phoenix9668/Collector/Doc/Collector Case Design/Collector antenna 1.jpg

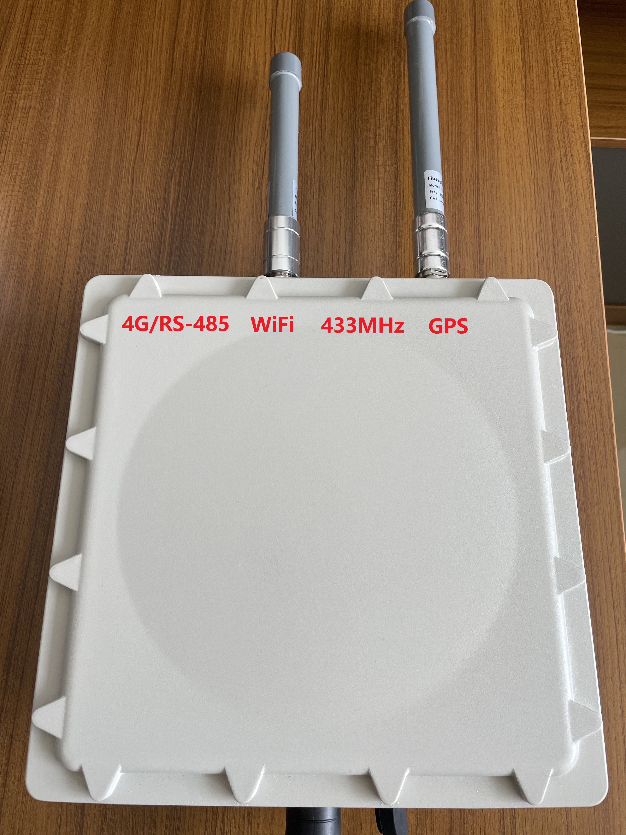
Doc/Collector Case Design/Collector antenna 1.jpg
