phoenix9668/Collector/Doc/Collector Case Design/Collector antenna 2.jpg

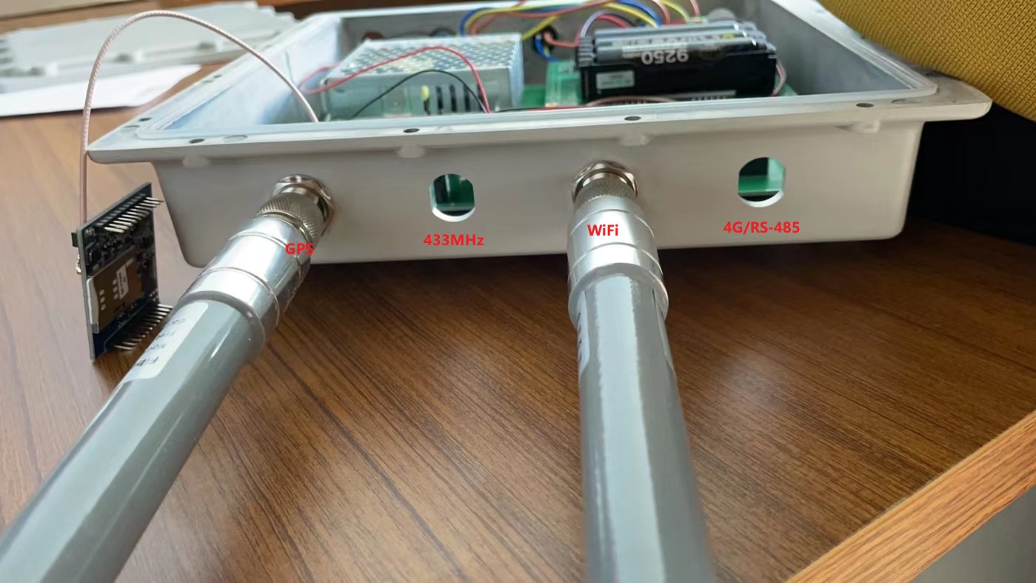
Doc/Collector Case Design/Collector antenna 2.jpg
