phoenix9668/Collector/README.md

# Collector
Collector code using freeRTOS on stm32l051c8t6.

Function Include:
1. CC1101 drive;
2. USART using DMA for efficient RX and TX transmission;
3. I2C-Compatible Serial Interface for SGM58031.
