phoenix9668/Collector/Doc/Collector Case Design/268×268×65mm case/基站印刷体.jpg

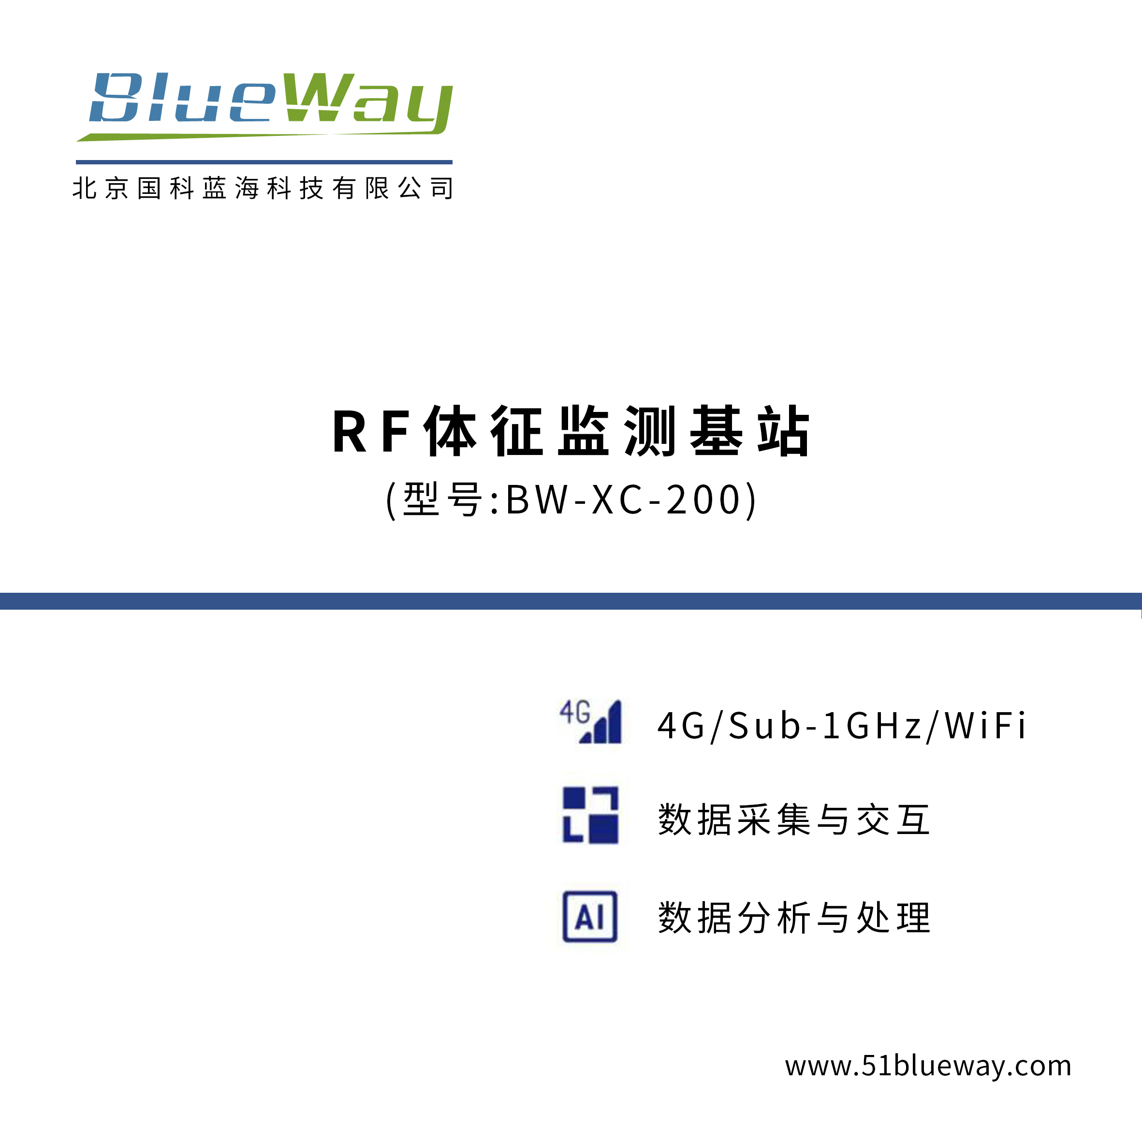
Doc/Collector Case Design/268×268×65mm case/基站印刷体.jpg
