phoenix9668/Collector/Doc/Collector Case Design/Collector Case-2.png

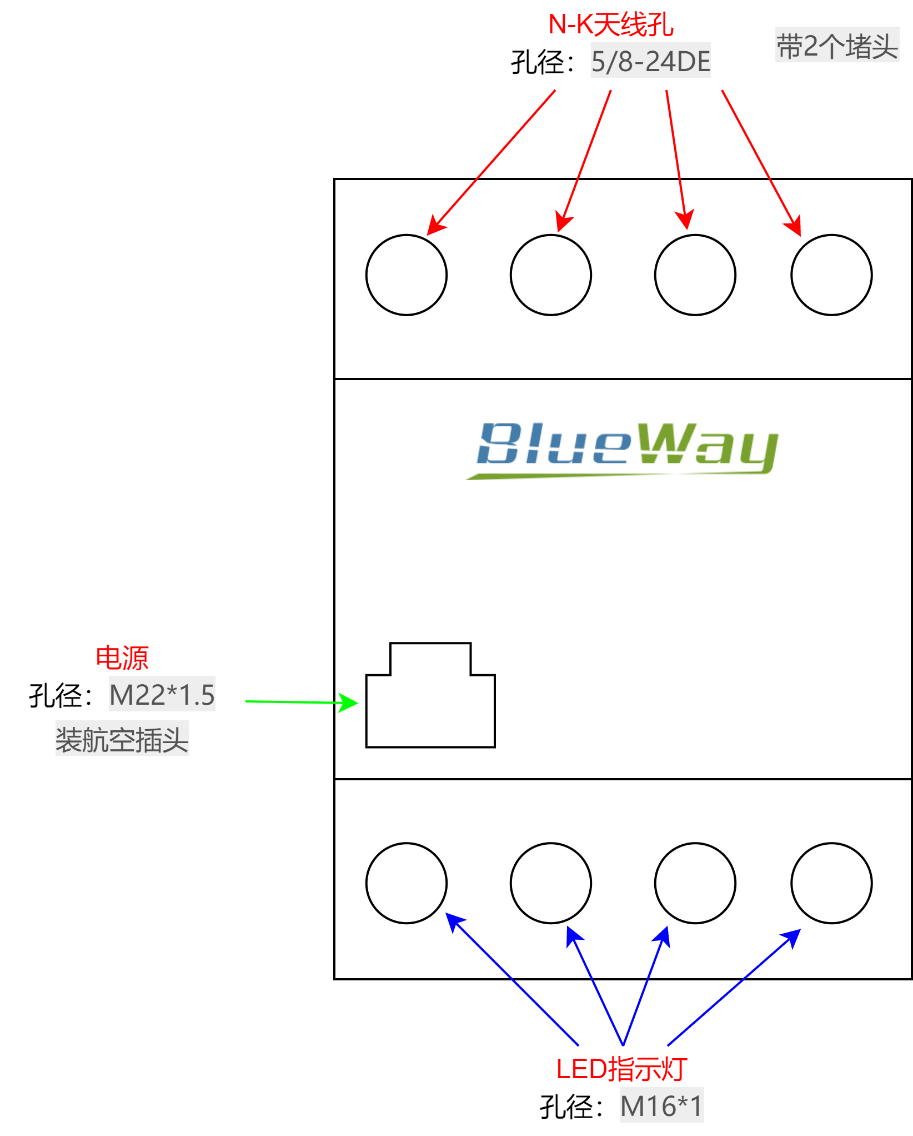
Doc/Collector Case Design/Collector Case-2.png
