phoenix9668/Collector/Doc/Collector Case Design/Collector Case.png

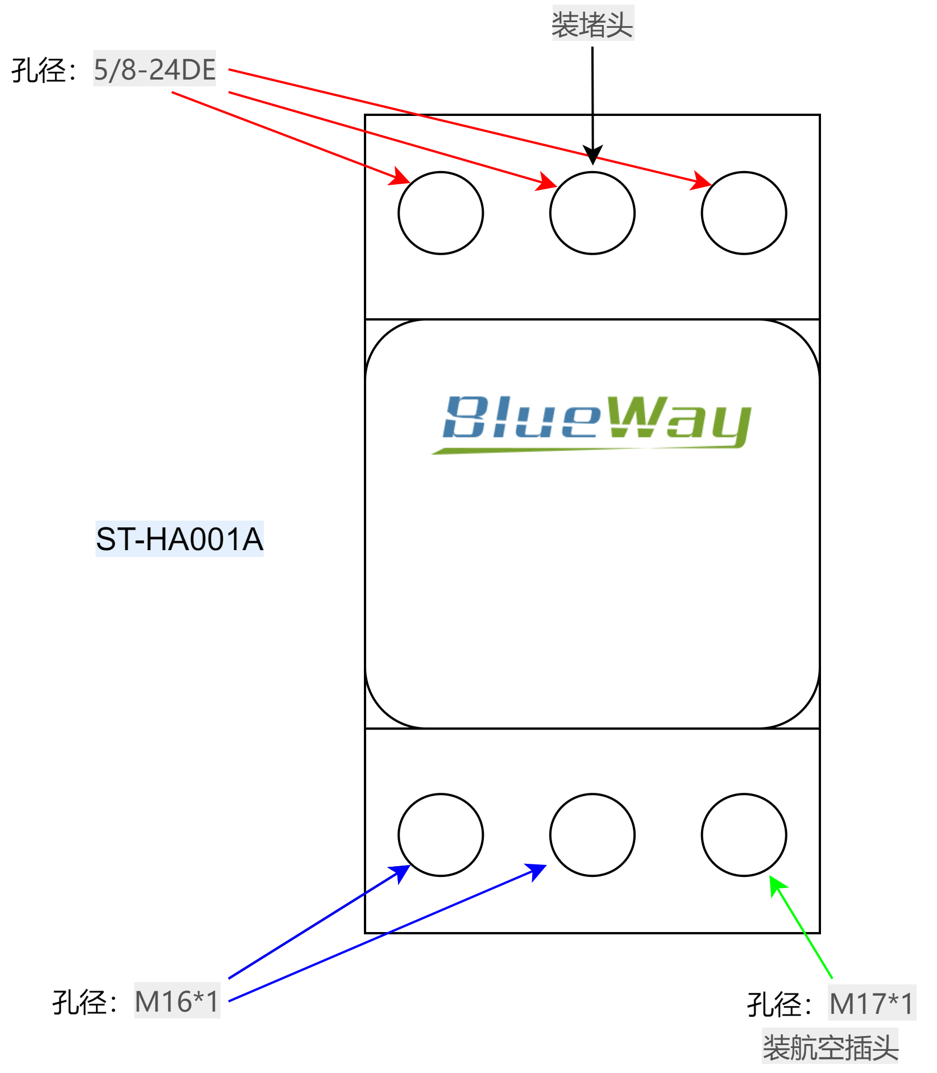
Doc/Collector Case Design/Collector Case.png
