phoenix9668/Collector/Doc/Hardware Protocol-Collar Hardware Send Protocol.png

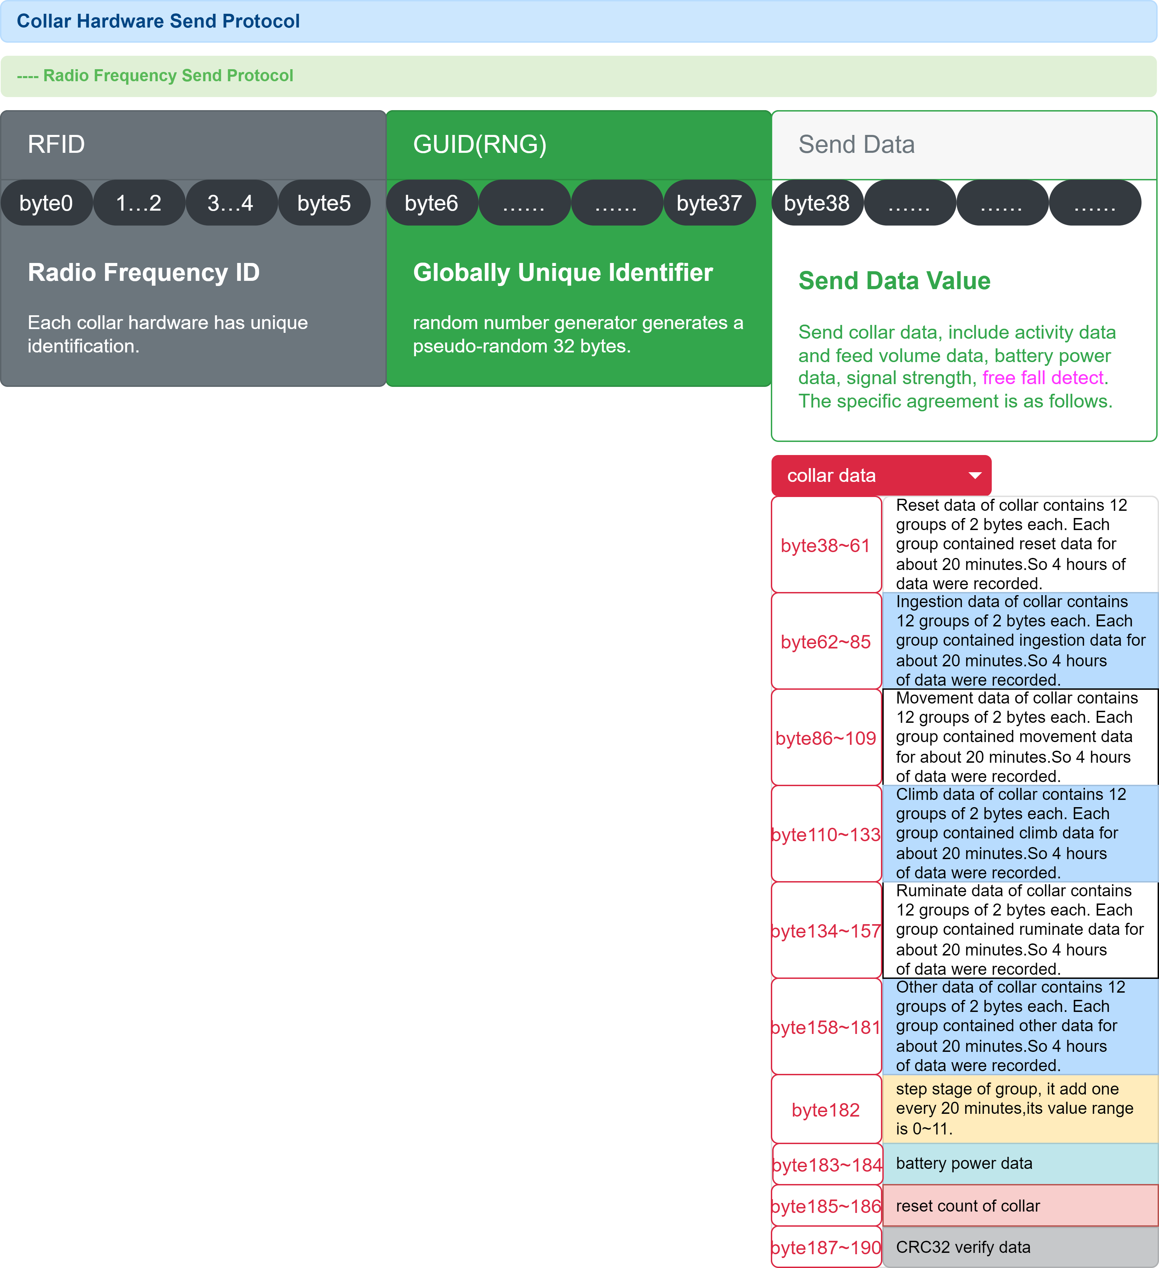
Doc/Hardware Protocol-Collar Hardware Send Protocol.png
