phoenix9668/Collector/Doc/Hardware Protocol-Collector Hardware Log Message Protocol.png

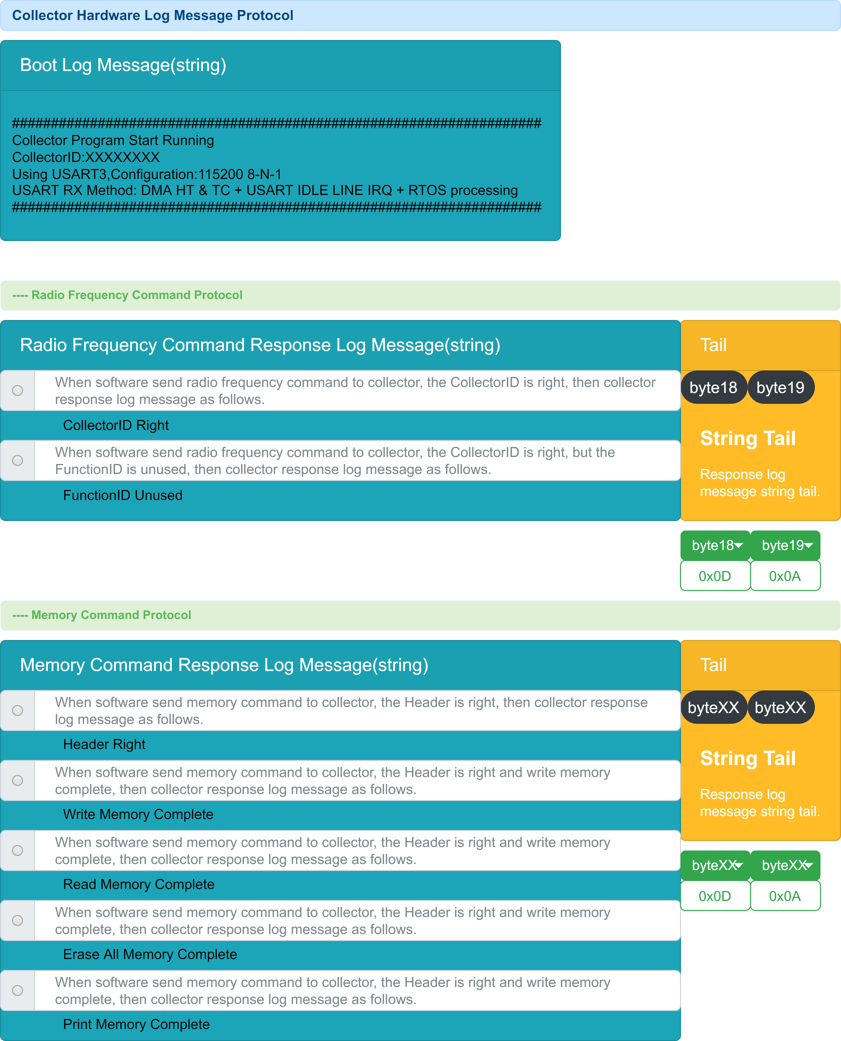
Doc/Hardware Protocol-Collector Hardware Log Message Protocol.png
