phoenix9668/Collector/Doc/Purchase Contract/Collector电路板及配件(2024.7.29)(20套).xls

Collector(20套)
壳体及其配件
Description | Quantity | Purchasing Options | Cost | Total Cost | 重要信息 | Necessary | Address | Purchasing Link
4G LTE玻璃钢全向天线 | 20 | 4G/LTE/5.5dBi/25cm/N公头 | 49 | 980 |  | 必备 | 寄往呼市办公室 | https://detail.tmall.com/item.htm?_u=e2mr66e994e&id=614809393316&skuId=4865627207627
IPEX转NK转接线 | 40 | 0.2m | 15 | 600 |  | 必备 | 寄往呼市办公室 | https://item.taobao.com/item.htm?id=620485895209
433MHz户外全向玻璃钢天线 | 20 | 433M/5dBi/48cm/N公头 | 98 | 1960 |  | 必备 | 寄往呼市办公室 | https://detail.tmall.com/item.htm?id=614809393316&_u=e2mr66e994e&skuId=4350249496926
220V转24V电源 75W 明纬 | 20 | LRS-75-24 |24V 3.2A | 55 | 1100 |  | 必备 | 寄往呼市办公室 | https://detail.tmall.com/item.htm?id=547707125576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
19mm金属指示灯 | 20 | Ø19mm | 平头 绿色 引线 3V（给客服备注） | 10.96 | 219.2 |  | 必备 | 寄往呼市办公室 | https://item.taobao.com/item.htm?spm=a1z10.5-c.w4002-20025268920.10.3d235fb6DVetfq&id=668912407685
16mm防水超短带灯 | 20 | 【复位】12-24V蓝 焊线（给客服备注） | 15 | 300 | 按照订单号: 2024060322001166131408393183提供 | 必备 | 寄往呼市办公室 | https://detail.tmall.com/item.htm?_u=22mr66e6bc4&id=677664819192&skuId=4865394269373
19mm自锁开关 | 20 | 19mm | 红色 220V 自锁开关 | 31.5 | 630 |  | 必备 | 寄往呼市办公室 | https://detail.tmall.com/item.htm?id=650041469068&skuId=5238024226194
防水航空插头 | 20 | LP20型3芯法兰正装 | 38.6 | 772 |  | 必备 | 寄往呼市办公室 | https://item.taobao.com/item.htm?spm=a1z10.5-c-s.w4002-17432376850.14.6a7935a3CgmxDe&id=565626258496
带保护板18650电池盒 | 20 |  | 36 | 720 |  | 必备 | 寄往呼市办公室 | https://item.taobao.com/item.htm?spm=a1z09.2.0.0.83f82e8dDwVs01&id=13633189376&_u=n2mr66e2dfd
德力普18650锂电池 | 20 | 平头9250mwh/2500mah*2节+【送同款1节】 | 34 | 680 |  | 必备 | 寄往呼市办公室 | https://detail.tmall.com/item.htm?id=601488730401&_u=n2mr66eae09&skuId=4204629100098
三芯电源线10A单头裸尾1平方 | 20 | 10A【1平方】3c认证 三插裸尾线 3M | 19.8 | 396 |  | 必备 | 寄往呼市办公室 | https://detail.tmall.com/item.htm?id=750570376980&_u=d2mr66ebe12&skuId=5178666565367
插头插拔式接线端子连接器2EDGK2.54 5P | 25 | 2EDGK-2.54-5P 插头（2个） | 4 | 100 |  | 必备 | 寄往呼市办公室 | https://detail.tmall.com/item.htm?id=654570375802&_u=d2mr66e8a34&skuId=4716054892312
插头插拔式接线端子连接器2EDGK5.08 2P | 20 | 2P-5.08-插头 铜方块 （5个） | 2.4 | 48 |  | 必备 | 寄往呼市办公室 | https://detail.tmall.com/item.htm?id=660116496745&skuId=4936499854311
模块
移远4G模块EC600N开发板 | 20 | 【搭载EC600UCNLB蓝牙版本】开发板QTME0028DB 80%客户选择 | 95 | 1900 |  | 必备 | 寄往呼市办公室 | https://detail.tmall.com/item.htm?id=633487849294&_u=n2mr66ed74e&skuId=4736799953269
 |  |  |  | 10405.2
