phoenix9668/Collector/Doc/Purchase Contract/Collector(体征监测基站)配件自锁开关.xls

Collector(100套)
壳体及内外部配件
Description | Quantity | Purchasing Options | Cost | Necessary | Address | Purchasing Link | Total Cost | 重要信息
19mm自锁开关 | 10 | 19mm | 红色 220V 自锁开关 | 31.5 | 必备 | 寄往呼市办公室 | https://detail.tmall.com/item.htm?id=650041469068&skuId=5238024226194 | 315
 |  |  |  |  |  |  | 315
