phoenix9668/Collector/Doc/Purchase Contract/Collector电路板及配件(2024.4.2)(10套).xls

Collector(10套)
壳体及其配件
Description | Quantity | Purchasing Options | Cost | Necessary | Address | Purchasing Link | Total Cost | 重要信息
4G LTE玻璃钢全向天线 | 10 | 4G/LTE/5.5dBi/25cm/N公头 | 49 | 必备 | 寄往呼市办公室 | https://detail.tmall.com/item.htm?_u=e2mr66e994e&id=614809393316&skuId=4865627207627 | 490
IPEX转NK转接线 | 20 | 0.2m | 15 | 必备 | 寄往呼市办公室 | https://item.taobao.com/item.htm?id=620485895209 | 300
433MHz户外全向玻璃钢天线 | 10 | 433M/5dBi/48cm/N公头 | 98 | 必备 | 寄往呼市办公室 | https://detail.tmall.com/item.htm?id=614809393316&_u=e2mr66e994e&skuId=4350249496926 | 980
220V转24V电源 75W 明纬 | 10 | LRS-75-24 |24V 3.2A | 55 | 必备 | 寄往呼市办公室 | https://detail.tmall.com/item.htm?id=547707125576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 | 550
19mm金属指示灯 | 10 | Ø19mm | 平头 绿色 引线 3V（给客服备注） | 10.96 | 必备 | 寄往呼市办公室 | https://item.taobao.com/item.htm?spm=a1z10.5-c.w4002-20025268920.10.3d235fb6DVetfq&id=668912407685 | 109.6
16mm防水超短带灯 | 10 | 【复位】12-24V蓝 焊线（给客服备注） | 15 | 必备 | 寄往呼市办公室 | https://detail.tmall.com/item.htm?_u=22mr66e6bc4&id=677664819192&skuId=4865394269373 | 150 | 按照订单号: 3681758306794062286提供
19mm自锁开关 | 10 | 19mm | 红色 220V 自锁开关 | 31.5 | 必备 | 寄往呼市办公室 | https://detail.tmall.com/item.htm?id=650041469068&skuId=5238024226194 | 315
防水航空插头 | 10 | LP20型3芯法兰正装 | 38.6 | 必备 | 寄往呼市办公室 | https://item.taobao.com/item.htm?spm=a1z10.5-c-s.w4002-17432376850.14.6a7935a3CgmxDe&id=565626258496 | 386
带保护板18650电池盒 | 10 |  | 36 | 必备 | 寄往呼市办公室 | https://item.taobao.com/item.htm?spm=a1z09.2.0.0.83f82e8dDwVs01&id=13633189376&_u=n2mr66e2dfd | 360
德力普18650锂电池 | 12 | 平头9250mwh/2500mah*2节+【送同款1节】 | 34 | 必备 | 寄往呼市办公室 | https://detail.tmall.com/item.htm?id=601488730401&_u=n2mr66eae09&skuId=4204629100098 | 408
模块
移远4G模块EC600N开发板 | 10 | 【搭载EC600UCNLB蓝牙版本】开发板QTME0028DB 80%客户选择 | 95 | 必备 | 寄往呼市办公室 | https://detail.tmall.com/item.htm?id=633487849294&_u=n2mr66ed74e&skuId=4736799953269 | 950
 |  |  |  |  |  |  | 4998.6
