phoenix9668/Collector/Doc/Purchase Contract/Collector配件(2023.11.20).xls

Collector
壳体及其配件
Description | Quantity | Purchasing Options | Cost | Necessary | Address | Purchasing Link | Total Cost | 重要信息
4G LTE玻璃钢全向天线 | 3 | 4G/LTE/5.5dBi/25cm/N公头 | 49 | 必备 | 寄往呼市办公室 | https://detail.tmall.com/item.htm?_u=e2mr66e994e&id=614809393316&skuId=4865627207627 | 147
IPEX转NK转接线 | 20 | 0.2m | 15 | 必备 | 寄往呼市办公室 | https://item.taobao.com/item.htm?id=620485895209 | 300
433MHz户外全向玻璃钢天线 | 3 | 433M/5dBi/48cm/N公头 | 98 | 必备 | 寄往呼市办公室 | https://detail.tmall.com/item.htm?id=614809393316&_u=e2mr66e994e&skuId=4350249496926 | 294
 |  |  |  |  |  |  | 741
