phoenix9668/Collector/Doc/Purchase Contract/Collector天线(2022.2.14).xls

Collector
LibRef | Quantity | Comment | Description | Footprint | Cost | Total Cost | Address | Manufacturer
4G户外全向玻璃钢天线 | 10 | 4G/LTE/6dBi/30cm/N公头 | 433/868/915MHz户外全向2.4G/5.8G/WiFi防水4G全频段玻璃钢天线 |  | 88 | 880 | 寄往呼市办公室 | https://detail.tmall.com/item.htm?id=614809393316&_u=e2mr66e994e&skuId=4350249496926
GPS/BD北斗双模卫星定位玻璃钢天线 | 10 | GPS+北斗玻璃钢天线 N公头 | GPS/BD北斗双模卫星定位天线gps玻璃钢/内置/吸盘/车载导航天线 |  | 58 | 580 | 寄往呼市办公室 | https://detail.tmall.com/item.htm?id=615922225062&scene=taobao_shop&skuId=4486120856083
433MHz户外全向玻璃钢天线 | 10 | 433M/5dBi/48cm/N公头 | 433/868/915MHz户外全向2.4G/5.8G/WiFi防水4G全频段玻璃钢天线 |  | 118 | 1180 | 寄往呼市办公室 | https://detail.tmall.com/item.htm?id=614809393316&_u=e2mr66e994e&skuId=4350249496926
 | 100 | 433M/4dBi/20cm/N公头 | 433/868/915MHz户外全向2.4G/5.8G/WiFi防水4G全频段玻璃钢天线 |  | 78 | 7800 | 寄往呼市办公室
N-K转接线 | 10 | N-K转SMA-J转接线/线长1米 | 玻璃钢天线固定夹码抱窋/N-K转接线N-K磁铁吸盘底座安装配件3D-FB |  | 28 | 280 | 寄往呼市办公室 | https://detail.tmall.com/item.htm?id=620297916107&spm=a1z09.2.0.0.38882e8dRRjwCa&_u=e2mr66e8020
 |  |  |  |  |  | 10720
