phoenix9668/Collector/Doc/Purchase Contract/4G模组和网络分析仪(2025.4.6).xls

网络分析仪(1套)
Description | Quantity | U8编码 | Purchasing Options | Cost | Total Cost | Necessary | Address | Purchasing Link
EC200X QuecPython开发板 | 1 |  | 【搭载EC200UEUAA模块】开发板QTMKFB0006DP | 315 | 315 | 必备 | 寄往呼市办公室 | https://detail.tmall.com/item.htm?id=826342921519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
LibreVNA2025网络分析仪 | 1 |  | 2025增强版LibreVNA | 3346.5 | 3346.5 | 必备 | 寄往呼市办公室 | https://item.taobao.com/item.htm?id=756767130374&skuId=5713249256603
高速ADC数据采集开发板 | 1 |  | 颜色分类：高速数据采集（套餐3） 标配+10位双通道高速ADC 套餐类型：XC7A100T+Xilinx下载器 | 1335.6 | 1335.6 | 必备 | 寄往呼市办公室 | https://detail.tmall.com/item.htm?id=820919611334&skuId=5536354565553
 |  |  |  |  | 4997.1
