phoenix9668/Collector/Doc/Purchase Contract/Collector(体征监测基站)生产BOM((100套).xls

Collector(100套)
壳体及内外部配件
Description | Quantity | Purchasing Options | Cost | Necessary | Address | Purchasing Link | Total Cost | 重要信息
铸铝防水壳体 | 100 | （裸壳）+卡具 | 310 | 必备 | 寄往呼市办公室 | https://item.taobao.com/item.htm?spm=a1z09.2.0.0.4acc2e8dhRLuoy&id=625369751753&_u=h2mr66e95b3 | 31000 | 我有此工厂淘宝客服的微信（17802788185），按100套走价格会有优惠，需要砍价
4G LTE玻璃钢全向天线 | 100 | 4G LTE 天线 | 50 | 必备 | 寄往呼市办公室 |  | 5000
IPEX转NK转接线 | 100 | 2根IPEX转NK | 30 | 必备 | 寄往呼市办公室 |  | 3000
天线接口激光镭射丝印 | 100 | 联系客服 | 20 | 必备 | 寄往呼市办公室 |  | 2000
logo印刷费 | 100 | 联系客服 | 15 | 必备 | 寄往呼市办公室 |  | 1500
GPS/BD北斗双模卫星定位玻璃钢天线 | 0 | GPS+北斗玻璃钢天线 N公头 | 58 | 选配 | 寄往呼市办公室 | https://detail.tmall.com/item.htm?id=615922225062&scene=taobao_shop&skuId=4486120856083 | 0 | 数量为0的本次不需要采购，下同
433MHz户外全向玻璃钢天线 | 100 | 433M/4dBi/20cm/N公头 | 78 | 必备 | 寄往呼市办公室 | https://detail.tmall.com/item.htm?id=614809393316&_u=e2mr66e994e&skuId=4350249496926 | 7800
220V转24V电源 75W 明纬 | 100 | LRS-75-24 |24V 3.2A | 63 | 必备 | 寄往呼市办公室 | https://detail.tmall.com/item.htm?id=547707125576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 | 6300
19mm金属指示灯 | 100 | Ø19mm | 平头 绿色 引线 3V（给客服备注） | 10.96 | 必备 | 寄往呼市办公室 | https://item.taobao.com/item.htm?spm=a1z10.5-c.w4002-20025268920.10.3d235fb6DVetfq&id=668912407685 | 1096
16mm防水超短带灯 | 100 | 【复位】12-24V蓝 焊线（给客服备注） | 15 | 必备 | 寄往呼市办公室 | https://detail.tmall.com/item.htm?_u=22mr66e6bc4&id=677664819192&skuId=4865394269373 | 1500 | 按照订单号: 2024060322001166131408393183提供
19mm自锁开关 | 100 | 19mm | 红色 220V 自锁开关 | 31.5 | 必备 | 寄往呼市办公室 | https://detail.tmall.com/item.htm?id=650041469068&skuId=5238024226194 | 3150
防水航空插头 | 100 | LP20型3芯法兰正装 | 38.6 | 必备 | 寄往呼市办公室 | https://item.taobao.com/item.htm?spm=a1z10.5-c-s.w4002-17432376850.14.6a7935a3CgmxDe&id=565626258496 | 3860
带保护板18650电池盒 | 100 |  | 36 | 必备 | 寄往呼市办公室 | https://item.taobao.com/item.htm?spm=a1z09.2.0.0.83f82e8dDwVs01&id=13633189376&_u=n2mr66e2dfd | 3600
5.5-2.1DC公插头 | 100 |  | 1.5 | 必备 | 寄往呼市办公室 | https://item.taobao.com/item.htm?spm=a1z09.2.0.0.83f82e8dDwVs01&id=17908412942&_u=n2mr66ecb35 | 150
德力普18650锂电池 | 100 | 平头9250mwh/2500mah*2节+【送同款1节】 | 34 | 必备 | 寄往呼市办公室 | https://detail.tmall.com/item.htm?id=601488730401&_u=n2mr66eae09&skuId=4204629100098 | 3400
第三方电路板模块 |  |  |  |  |  |  | 0
移远4G模块EC600N开发板 | 100 | 【搭载EC600MCNLE模块】开发板QTME0068DM | 199 | 必备 | 寄往呼市办公室 | https://detail.tmall.com/item.htm?id=633487849294&_u=n2mr66ed74e&skuId=4736799953269 | 19900
有人物联网4G模块 | 0 | 新版V2（V1版迭代产品） | 138 | 选配 | 寄往呼市办公室 | https://detail.tmall.com/item.htm?id=540412354139&scene=taobao_shop&skuId=4189121103787 | 0
RS485隔离通信模块 | 0 | RSM485HT3S | 23 | 选配 | 寄往呼市办公室 | https://detail.tmall.com/item.htm?id=626362889334&scene=taobao_shop&skuId=4443886261820 | 0
gps卫星定位模块 | 0 | GPS模块 | 17 | 选配 | 寄往呼市办公室 | https://detail.tmall.com/item.htm?id=624586693428&_u=i2mr66e4e78&skuId=4732981904154 | 0
装配耗材 |  |  |  |  |  |  | 0
304十字薄头机丝M4*8 | 10 | M4*8[50只] | 4.6 | 必备 | 寄往呼市办公室 | https://detail.tmall.com/item.htm?id=641493636015&_u=n2mr66e24b7&skuId=4617286433580 | 46 | 实际一个基站需要的数量:3个
双通六角铜柱M3*11 | 25 | M3*11[20颗] | 2.4 | 必备 | 寄往呼市办公室 | https://detail.tmall.com/item.htm?id=542213588710&_u=n2mr66e1134&skuId=4495523787442 | 60 | 实际一个基站需要的数量:4个
铜杯头内六角M3*5 | 25 | M3*5(20只) | 2.5 | 必备 | 寄往呼市办公室 | https://detail.tmall.com/item.htm?id=669122944941&_u=n2mr66ee506&skuId=4815908936418 | 62.5 | 实际一个基站需要的数量:4个
铜十字圆头机丝M3*5 | 10 | M3*5[50只] | 2.8 | 必备 | 寄往呼市办公室 | https://detail.tmall.com/item.htm?id=668995716067&_u=n2mr66e1896&skuId=4820009109460 | 28 | 实际一个基站需要的数量:4个
双通六角铜柱M2*11 | 10 | M2*11[20颗] | 2.1 | 必备 | 寄往呼市办公室 | https://detail.tmall.com/item.htm?id=542213588710&_u=n2mr66e1134&skuId=4789232336141 | 21 | 实际一个基站需要的数量:2个
铜十字圆头机丝M2*5 | 4 | M2*5[50只] | 1.9 | 必备 | 寄往呼市办公室 | https://detail.tmall.com/item.htm?id=668995716067&_u=n2mr66e1896&skuId=4820009109449 | 7.6 | 实际一个基站需要的数量:4个
304组合套装螺丝（圆头机丝+螺母+平垫+弹垫） | 5 | M3*8[50套] | 4.8 | 必备 | 寄往呼市办公室 | https://detail.tmall.com/item.htm?id=637072501037&_u=n2mr66e7406&skuId=4739472298061 | 24 | 实际一个基站需要的数量:2套
304组合套装螺丝（沉头机丝+螺母+平垫） | 10 | M2*6[50套] | 6.2 | 必备 | 寄往呼市办公室 | https://detail.tmall.com/item.htm?id=637264050171&_u=n2mr66ec58f&skuId=4738087554970 | 62 | 实际一个基站需要的数量:4套
自研电路板 |  |  |  |  |  |  | 0
RFID_CC1101_433MHz Rev3.1 | 100 | RFID_CC1101_433MHz Rev3.1（2022.4.8） | 125.9 | 必备 | 寄往呼市办公室 | 这块板子之前生产过，本次为复投，具体金额以合同为准 | 12590 | 由PCBA工厂报价
Collector_PowerManagementSubboard Rev1.1 | 100 | Collector_PowerManagementSubboard Rev1.1（2022.4.24） | 194.6 | 必备 | 寄往呼市办公室 | 这块板子之前生产过，本次为复投，具体金额以合同为准 | 19460 | 由PCBA工厂报价
 |  |  |  |  |  |  | 125617.1
