phoenix9668/Collector/Doc/Purchase Contract/Collector电路板及配件(2024.7.29)(20套)(补充).xls

Collector(20套)
配件
Description | Quantity | Purchasing Options | Cost | Total Cost | 重要信息 | Necessary | Address | Purchasing Link
三芯电源线10A单头裸尾1平方 | 20 | 10A【1平方】3c认证 三插裸尾线 3M | 19.8 | 396 |  | 必备 | 寄往呼市办公室 | https://detail.tmall.com/item.htm?id=750570376980&_u=d2mr66ebe12&skuId=5178666565367
EVEPS隔离型12V转12V车载电瓶稳压器直流电源9-36V转12V转换模块 | 5 | 9-36V转12V5A 隔离大塑J3 | 78 | 390 |  | 必备 | 寄往呼市办公室 | https://detail.tmall.com/item.htm?id=656299791466&scm=1007.13982.82927.0&last_time=1723599657
插头插拔式接线端子连接器2EDGK2.54 5P | 25 | 2EDGK-2.54-5P 插头（2个） | 4 | 100 |  | 必备 | 寄往呼市办公室 | https://detail.tmall.com/item.htm?id=654570375802&_u=d2mr66e8a34&skuId=4716054892312
插头插拔式接线端子连接器2EDGK5.08 2P | 20 | 2P-5.08-插头 铜方块 （5个） | 2.4 | 48 |  | 必备 | 寄往呼市办公室 | https://detail.tmall.com/item.htm?id=660116496745&skuId=4936499854311
 |  |  |  | 934
