phoenix9668/Collector/Doc/Purchase Contract/国际版4G模组(2025.4.21).xls

网络分析仪(1套)
Description | Quantity | U8编码 | Purchasing Options | Cost | Total Cost | Necessary | Address | Purchasing Link
EC200X QuecPython开发板 | 2 |  | 【搭载EC200UEUAA模块】开发板QTMKFB0006DP | 315 | 630 | 必备 | 寄往呼市办公室 | https://detail.tmall.com/item.htm?id=826342921519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
 |  |  |  |  | 630
