phoenix9668/Collector/Doc/Purchase Contract/工控机内存条采购.xls

发情监测
工控机
Description | Quantity | Purchasing Options | 购买备注(重要) | Cost | Total Cost | Necessary | Address | Purchasing Link
英睿达DDR5笔记本内存条 | 1 | 5600MHz 【美光】笔记本套条 16GB*2 |  | 599 | 599 | 必备 |  | https://detail.tmall.com/item.htm?id=675629158503&scene=taobao_shop&skuId=5556115374810
 |  |  |  |  | 599
