phoenix9668/Collector/Doc/Purchase Contract/Collector电路板及配件(2023.7.13).xls

Collector
壳体及其配件
Description | Quantity | Purchasing Options | Cost | Necessary | Address | Purchasing Link | Total Cost | 重要信息
4G LTE玻璃钢全向天线 | 90 | 4G/LTE/5.5dBi/25cm/N公头 | 49 | 必备 | 寄往呼市办公室 | https://detail.tmall.com/item.htm?_u=e2mr66e994e&id=614809393316&skuId=4865627207627 | 4410
IPEX转NK转接线 | 90 | 0.2m | 15 | 必备 | 寄往呼市办公室 | https://item.taobao.com/item.htm?id=620485895209 | 1350
GPS/BD北斗双模卫星定位玻璃钢天线 | 0 | GPS+北斗玻璃钢天线 N公头 | 58 | 选配 | 寄往呼市办公室 | https://detail.tmall.com/item.htm?id=615922225062&scene=taobao_shop&skuId=4486120856083 | 0 | 数量为0的本次不需要采购，下同
433MHz户外全向玻璃钢天线 | 90 | 433M/5dBi/48cm/N公头 | 98 | 必备 | 寄往呼市办公室 | https://detail.tmall.com/item.htm?id=614809393316&_u=e2mr66e994e&skuId=4350249496926 | 8820
220V转24V电源 75W 明纬 | 90 | LRS-75-24 |24V 3.2A | 55 | 必备 | 寄往呼市办公室 | https://detail.tmall.com/item.htm?id=547707125576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 | 4950
19mm金属信号灯 | 90 | 绿色 引线 3V（给客服备注） Ø19mm | 平头信号灯 | 10.96 | 必备 | 寄往呼市办公室 | https://item.taobao.com/item.htm?spm=a1z10.5-c.w4002-20025268920.10.3d235fb6DVetfq&id=668912407685 | 986.4
 | 90 | 12V 黄色 16mm | 12.46 | 必备 | 寄往呼市办公室 | https://item.taobao.com/item.htm?spm=a1z10.5-c-s.w4002-20025268920.10.4f0e5c6cBxaSQF&id=639898306590 | 1121.4
 | 90 | 红色 220V 自复 19mm | 环形灯 | 25.9 | 必备 | 寄往呼市办公室 | https://item.taobao.com/item.htm?spm=a1z10.5-c.w4002-20025268920.22.390c1d56cbmVZk&id=669515881748 | 2331
防水航空插头 | 90 | LP20型3芯法兰正装 | 38.6 | 必备 | 寄往呼市办公室 | https://item.taobao.com/item.htm?spm=a1z10.5-c-s.w4002-17432376850.14.6a7935a3CgmxDe&id=565626258496 | 3474
带保护板18650电池盒 | 90 |  | 36 | 必备 | 寄往呼市办公室 | https://item.taobao.com/item.htm?spm=a1z09.2.0.0.83f82e8dDwVs01&id=13633189376&_u=n2mr66e2dfd | 3240
5.5-2.1DC公插头弯头线 | 90 |  | 1.05 | 必备 | 寄往呼市办公室 | https://item.taobao.com/item.htm?spm=a1z09.2.0.0.788c2e8d9yUXKU&id=550496485516&_u=d2mr66ee21c | 94.5
德力普18650锂电池 | 90 | 平头9250mwh/2500mah*2节+【送同款1节】 | 34 | 必备 | 寄往呼市办公室 | https://detail.tmall.com/item.htm?id=601488730401&_u=n2mr66eae09&skuId=4204629100098 | 3060
模块
移远4G模块EC600N开发板 | 90 | QTME0027DD【搭载EC600NCNLD-N06-UNNDA模组】 | 168 | 必备 | 寄往呼市办公室 | https://detail.tmall.com/item.htm?id=633487849294&_u=n2mr66ed74e&skuId=4736799953269 | 15120
有人物联网4G模块 | 0 | 新版V2（V1版迭代产品） | 138 | 选配 | 寄往呼市办公室 | https://detail.tmall.com/item.htm?id=540412354139&scene=taobao_shop&skuId=4189121103787 | 0
RS485隔离通信模块 | 0 | RSM485HT3S | 23 | 选配 | 寄往呼市办公室 | https://detail.tmall.com/item.htm?id=626362889334&scene=taobao_shop&skuId=4443886261820 | 0
gps卫星定位模块 | 0 | GPS模块 | 17 | 选配 | 寄往呼市办公室 | https://detail.tmall.com/item.htm?id=624586693428&_u=i2mr66e4e78&skuId=4732981904154 | 0
装配耗材
304十字薄头机丝M4*8 | 10 | M4*8[50只] | 4.6 | 必备 | 寄往呼市办公室 | https://detail.tmall.com/item.htm?id=641493636015&_u=n2mr66e24b7&skuId=4617286433580 | 46
双通六角铜柱M3*11 | 25 | M3*11[20颗] | 2.4 | 必备 | 寄往呼市办公室 | https://detail.tmall.com/item.htm?id=542213588710&_u=n2mr66e1134&skuId=4495523787442 | 60
铜杯头内六角M3*5 | 25 | M3*5(20只) | 2.5 | 必备 | 寄往呼市办公室 | https://detail.tmall.com/item.htm?id=669122944941&_u=n2mr66ee506&skuId=4815908936418 | 62.5
铜十字圆头机丝M3*5 | 10 | M3*5[50只] | 2.8 | 必备 | 寄往呼市办公室 | https://detail.tmall.com/item.htm?id=668995716067&_u=n2mr66e1896&skuId=4820009109460 | 28
双通六角铜柱M2*11 | 10 | M2*11[20颗] | 2.1 | 必备 | 寄往呼市办公室 | https://detail.tmall.com/item.htm?id=542213588710&_u=n2mr66e1134&skuId=4789232336141 | 21
铜十字圆头机丝M2*5 | 4 | M2*5[50只] | 1.9 | 必备 | 寄往呼市办公室 | https://detail.tmall.com/item.htm?id=668995716067&_u=n2mr66e1896&skuId=4820009109449 | 7.6
304组合套装螺丝（圆头机丝+螺母+平垫+弹垫） | 5 | M3*8[50套] | 4.8 | 必备 | 寄往呼市办公室 | https://detail.tmall.com/item.htm?id=637072501037&_u=n2mr66e7406&skuId=4739472298061 | 24
304组合套装螺丝（沉头机丝+螺母+平垫） | 10 | M2*6[50套] | 6.2 | 必备 | 寄往呼市办公室 | https://detail.tmall.com/item.htm?id=637264050171&_u=n2mr66ec58f&skuId=4738087554970 | 62
电路板
RFID_CC1101_433MHz Rev3.1 | 100 | RFID_CC1101_433MHz Rev3.1（2022.4.8） |  | 必备 | 寄往呼市办公室 | 这块板子之前生产过，本次为复投 | 0 | 由PCBA工厂报价
Collector_PowerManagementSubboard Rev1.1 | 100 | Collector_PowerManagementSubboard Rev1.1（2022.4.24） |  | 必备 | 寄往呼市办公室 | 这块板子之前生产过，本次为复投 | 0 | 由PCBA工厂报价
 |  |  |  |  |  |  | 49268.4
