phoenix9668/Collector/Doc/Purchase Contract/焊接工具及耗材(2023.11.20).xls

Collector
壳体及其配件
Description | Quantity | Purchasing Options | Cost | Necessary | Address | Purchasing Link | Total Cost | 重要信息
老A 9合1多功能尖嘴钳工业级剥线钳剪线钳迷你电工钳手工专用钳子 | 3 | 老A 9合1多功能电工钳 升级款（一把顶9把） | 69 | 必备 | 寄往呼市办公室 | https://detail.tmall.com/item.htm?id=649002336595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 | 207
老A 十字螺丝刀一字螺丝批改锥超硬工业级螺丝刀家用工具套装起子 | 2 | 5*150mm【一字】+【十字】 | 29 | 必备 | 寄往呼市办公室 | https://detail.tmall.com/item.htm?id=18727376166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 | 58
老A 十字螺丝刀一字螺丝批改锥超硬工业级螺丝刀家用工具套装起子 | 2 | 6*150mm【一字】+【十字】 | 30 | 必备 | 寄往呼市办公室 | https://detail.tmall.com/item.htm?id=18727376166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 | 60
老A 中国台湾原产电缆旋转剥皮器剥线钳拨线钳剥线器剥皮钳扒皮钳 | 1 |  | 113 | 必备 | 寄往呼市办公室 | https://detail.tmall.com/item.htm?id=524077500330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 | 113
老A 焊锡膏松香助焊剂助焊膏焊膏松香膏焊油手机维修焊接焊锡 | 1 | 25G+50G+25G组合装（立省7.9元） | 42 | 必备 | 寄往呼市办公室 | https://detail.tmall.com/item.htm?id=20051730270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 | 42
老A免清洗低温焊锡丝含锡量63% 0.5/0.8/1.0/1.2/2.0/1.5MM送松香 | 2 |  | 182 | 必备 | 寄往呼市办公室 | https://detail.tmall.com/item.htm?id=22496792181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 | 364
欧洁酒精75%度消毒液家用杀菌消毒免洗手乙醇消毒水瓶装500ml | 1 | 5瓶*75%酒精500ml【量贩装 性价比高】 | 51 | 必备 | 寄往呼市办公室 | https://detail.tmall.com/item.htm?abbucket=2&id=543499600863&ns=1&spm=a21n57.1.0.0.3cc5523cvOyEPd | 51
 |  |  |  |  |  |  | 895
