phoenix9668/Collector/Doc/Purchase Contract/海康威视4G摄像头(2023.1.30).xls

RFID体征监测项圈
摄像头及配件
Description | Quantity | Purchasing Options | Cost | Necessary | Address | Purchasing Link | Total Cost | 重要信息
海康威视4G摄像头 | 6 | 热卖款+4G流量版+断电续航 | 578 | 必备 | 寄往呼市办公室 | https://item.jd.com/100013136857.html#crumb-wrap | 3468
闪迪（SanDisk）256GB TF（MicroSD）存储卡 | 6 | TF卡至尊极速 256GB | 209 | 必备 | 寄往呼市办公室 | https://item.jd.com/6201910.html#crumb-wrap | 1254
 |  |  |  |  |  |  | 4722
