phoenix9668/Collector/Doc/Purchase Contract/Collector壳体，电路板及配件(2022.5.27).xls

Collector
壳体及其配件
Description | Quantity | Purchasing Options | Cost | Necessary | Address | Purchasing Link | Total Cost | 重要信息
铸铝防水壳体 | 100 | （裸壳）+卡具 | 310 | 必备 | 寄往呼市办公室 | https://item.taobao.com/item.htm?spm=a1z09.2.0.0.4acc2e8dhRLuoy&id=625369751753&_u=h2mr66e95b3 | 31000 | 我有此工厂淘宝客服的微信（17802788185），按100套走价格会有优惠，需要砍价
4G LTE玻璃钢全向天线 | 0 | 4G LTE 天线 | 50 | 必备 | 寄往呼市办公室 |  | 0
IPEX转NK转接线 | 10 | 2根IPEX转NK | 30 | 必备 | 寄往呼市办公室 |  | 300
天线接口激光镭射丝印 | 100 | 联系客服 | 20 | 必备 | 寄往呼市办公室 |  | 2000
logo印刷费 | 100 | 联系客服 | 15 | 必备 | 寄往呼市办公室 |  | 1500
GPS/BD北斗双模卫星定位玻璃钢天线 | 0 | GPS+北斗玻璃钢天线 N公头 | 58 | 选配 | 寄往呼市办公室 | https://detail.tmall.com/item.htm?id=615922225062&scene=taobao_shop&skuId=4486120856083 | 0 | 数量为0的本次不需要采购，下同
433MHz户外全向玻璃钢天线 | 0 | 433M/4dBi/20cm/N公头 | 78 | 必备 | 寄往呼市办公室 | https://detail.tmall.com/item.htm?id=614809393316&_u=e2mr66e994e&skuId=4350249496926 | 0
220V转24V电源 75W 明纬 | 10 | LRS-75-24 |24V 3.2A | 63 | 必备 | 寄往呼市办公室 | https://detail.tmall.com/item.htm?id=547707125576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 | 630
19mm金属信号灯 | 10 | 平形 19mm 接线柱 不锈钢 3V（给客服备注） 绿色 | 10.59 | 必备 | 寄往呼市办公室 | https://item.taobao.com/item.htm?spm=a1z09.2.0.0.1f3b2e8d2ldV9e&id=639192216387&_u=e2mr66ead5f | 105.9
 | 10 | 平形 19mm 接线柱 不锈钢 220V 红色 | 10.59 | 必备 | 寄往呼市办公室 |  | 105.9
防水航空插头 | 10 | LP20型3芯法兰正装 | 38.6 | 必备 | 寄往呼市办公室 | https://item.taobao.com/item.htm?spm=a1z10.5-c-s.w4002-17432376850.14.6a7935a3CgmxDe&id=565626258496 | 386
带保护板18650电池盒 | 10 |  | 36 | 必备 | 寄往呼市办公室 | https://item.taobao.com/item.htm?spm=a1z09.2.0.0.83f82e8dDwVs01&id=13633189376&_u=n2mr66e2dfd | 360
5.5-2.1DC公插头 | 10 |  | 1.5 | 必备 | 寄往呼市办公室 | https://item.taobao.com/item.htm?spm=a1z09.2.0.0.83f82e8dDwVs01&id=17908412942&_u=n2mr66ecb35 | 15
德力普18650锂电池 | 10 | 平头9250mwh/2500mah*2节+【送同款1节】 | 34 | 必备 | 寄往呼市办公室 | https://detail.tmall.com/item.htm?id=601488730401&_u=n2mr66eae09&skuId=4204629100098 | 340
模块 |  |  |  |  |  |  | 0
移远4G模块EC600N开发板 | 10 | QTME0027DD【搭载EC600NCNLD-N06-UNNDA模组】 | 168 | 必备 | 寄往呼市办公室 | https://detail.tmall.com/item.htm?id=633487849294&_u=n2mr66ed74e&skuId=4736799953269 | 1680
有人物联网4G模块 | 0 | 新版V2（V1版迭代产品） | 138 | 选配 | 寄往呼市办公室 | https://detail.tmall.com/item.htm?id=540412354139&scene=taobao_shop&skuId=4189121103787 | 0
RS485隔离通信模块 | 0 | RSM485HT3S | 23 | 选配 | 寄往呼市办公室 | https://detail.tmall.com/item.htm?id=626362889334&scene=taobao_shop&skuId=4443886261820 | 0
gps卫星定位模块 | 0 | GPS模块 | 17 | 选配 | 寄往呼市办公室 | https://detail.tmall.com/item.htm?id=624586693428&_u=i2mr66e4e78&skuId=4732981904154 | 0
装配耗材 |  |  |  |  |  |  | 0
304十字薄头机丝M4*8 | 10 | M4*8[50只] | 4.6 | 必备 | 寄往呼市办公室 | https://detail.tmall.com/item.htm?id=641493636015&_u=n2mr66e24b7&skuId=4617286433580 | 46
双通六角铜柱M3*11 | 25 | M3*11[20颗] | 2.4 | 必备 | 寄往呼市办公室 | https://detail.tmall.com/item.htm?id=542213588710&_u=n2mr66e1134&skuId=4495523787442 | 60
铜杯头内六角M3*5 | 25 | M3*5(20只) | 2.5 | 必备 | 寄往呼市办公室 | https://detail.tmall.com/item.htm?id=669122944941&_u=n2mr66ee506&skuId=4815908936418 | 62.5
铜十字圆头机丝M3*5 | 10 | M3*5[50只] | 2.8 | 必备 | 寄往呼市办公室 | https://detail.tmall.com/item.htm?id=668995716067&_u=n2mr66e1896&skuId=4820009109460 | 28
双通六角铜柱M2*11 | 10 | M2*11[20颗] | 2.1 | 必备 | 寄往呼市办公室 | https://detail.tmall.com/item.htm?id=542213588710&_u=n2mr66e1134&skuId=4789232336141 | 21
铜十字圆头机丝M2*5 | 4 | M2*5[50只] | 1.9 | 必备 | 寄往呼市办公室 | https://detail.tmall.com/item.htm?id=668995716067&_u=n2mr66e1896&skuId=4820009109449 | 7.6
304组合套装螺丝（圆头机丝+螺母+平垫+弹垫） | 5 | M3*8[50套] | 4.8 | 必备 | 寄往呼市办公室 | https://detail.tmall.com/item.htm?id=637072501037&_u=n2mr66e7406&skuId=4739472298061 | 24
304组合套装螺丝（沉头机丝+螺母+平垫） | 10 | M2*6[50套] | 6.2 | 必备 | 寄往呼市办公室 | https://detail.tmall.com/item.htm?id=637264050171&_u=n2mr66ec58f&skuId=4738087554970 | 62
Linu服务器平台 |  |  |  |  |  |  | 0
Firefly-RK3399 | 1 | 容量：2G+16G 套餐：单机标配 | 999 | 必备 | 寄往呼市办公室 | https://item.taobao.com/item.htm?spm=a1z0d.6639537.1997196601.153.30e67484DlEric&id=543209848686 | 999
10.1寸高清EDP液晶模组 | 1 |  | 599 | 必备 | 寄往呼市办公室 | https://item.taobao.com/item.htm?spm=a1z0d.6639537.1997196601.235.30e67484DlEric&id=553595001870 | 599
firefly-rk3399扇热风扇 | 1 | 金色 | 39 | 必备 | 寄往呼市办公室 | https://item.taobao.com/item.htm?spm=a1z10.3-c-s.w4002-22671079067.9.5b1b27a8jQ0g6g&id=546738955150 | 39
SSD | 1 | 选择颜色：Gen4旗舰新品 SE10极至超速 选择版本：2000G | 2099 | 必备 | 寄往呼市办公室 | https://item.jd.com/100015438989.html#crumb-wrap | 2099
GD32单片机（国产） |  |  |  |  |  |  | 0
GD-LINK | 1 |  | 299 | 必备 | 寄往呼市办公室 | https://detail.tmall.com/item.htm?id=577604067354&rn=a980b3d2d7f5281a5bff065ab094d900&abbucket=2 | 299
GD32E230C-EVAL | 1 |  | 329 | 必备 | 寄往呼市办公室 | https://detail.tmall.com/item.htm?id=585589871222&rn=a980b3d2d7f5281a5bff065ab094d900&abbucket=2 | 329
 |  |  |  |  |  |  | 43097.9
