phoenix9668/Collector/Doc/Purchase Contract/Collector设计生产工具(2022.3.18).xls

Sheet: BC26_GNSS_Project
Collector
项目 | Description | Quantity | Purchasing Options | Cost | Total Cost | Address | Purchasing Link | 发票
生产工具 | Bosch GO 2 电动螺丝刀 | 3 |  | 259 | 777 | 寄往呼市办公室 | https://item.jd.com/57056500284.html | 已开
 | 玺力HS-2202S组合螺丝刀 | 3 | 套餐3 | 146 | 438 | 寄往呼市办公室 | https://item.taobao.com/item.htm?id=542405081687&scene=taobao_shop | 已开
 | 镊子,电烙铁头等 | 1 |  | 253.03 | 253.03 | 寄往呼市办公室 | https://detail.tmall.com/item.htm?id=626861430166&spm=a1z09.2.0.0.8d0e2e8dCPAP0W&_u=i2mr66eda6c | 已开
研发焊接损耗 | 常用电容+常用电阻 | 1 | 共300种型号 | 714.74 | 714.74 | 寄往呼市办公室 | https://my.ickey.cn/order.html | 已开
 | 凝睿smt贴片元件盒 | 1 | 黑色版5盒装 | 635 | 635 | 寄往呼市办公室 | https://item.taobao.com/item.htm?spm=2013.1.630.21.1bd23355MZnFTG&id=45196370060 | 已开
 | 电阻值标签 | 1 | 0402 1% 128阻值1Ω-2M | 20 | 20 | 寄往呼市办公室 | https://item.taobao.com/item.htm?spm=2013.1.630.36.b8551b27QLZGyR&id=39931368278
 |  | 1 | 0603 1% 128阻值1Ω-2M | 20 | 20 | 寄往呼市办公室
 | 电容值标签 | 1 | 0402 0.5pF-2.2μF 68值 | 20 | 20 | 寄往呼市办公室 | https://item.taobao.com/item.htm?ft=t&id=42933241610&scene=taobao_shop
 |  | 1 | 不含封装0.5pF-100μF 80值 | 20 | 20 | 寄往呼市办公室
 | 空白标签 | 3 | 白色 | 5 | 15 | 寄往呼市办公室 | https://item.taobao.com/item.htm?ft=t&id=558236574557&scene=taobao_shop
 | 发票税点 | 1 |  | 72 | 72
新疆樊鑫项目 | 中国移动NB卡 | 13 | 300M/2年 | 81 | 1053 | 寄往呼市办公室 | http://www.simboss.com/palette/#/online/records | 已开
测试仪器 | mPower1203便携式直流分析电源 | 1 | 标准版开票 | 2920 | 2920 | 寄往呼市办公室 | https://item.taobao.com/item.htm?spm=a1z10.1-c-s.w4004-17786279155.2.bd295a1cr4D6cA&id=574217991932 | 已开
 | 璞石超便携触屏示波器 | 1 | DS4T1012(150M/1GSa/s/16Mpts) | 1499 | 1499 | 寄往呼市办公室 | https://item.taobao.com/item.htm?spm=a1z10.1-c-s.w4004-21944703227.10.3fc31f75peoOyu&id=659740017788 | 已开
研发样品 | gps卫星定位模块,FLASH存储模块 | 1 | GPS模块 | 128.29 | 128.29 | 寄往呼市办公室 | https://detail.tmall.com/item.htm?id=624586693428&_u=i2mr66e4e78&skuId=4732981904154 | 已开
 | 德力普18650锂电池 | 1 | 平头5550mwh/1500mah*2节+【送同款1节】 | 65 | 65 | 寄往呼市办公室 | https://detail.tmall.com/item.htm?id=601488730401&spm=a1z09.2.0.0.8d0e2e8dCPAP0W&_u=i2mr66e6e14 | 已开
 | UPS18650电池盒 | 3 | 18650【3串】电池盒无电芯[开关线透明无保护] | 30.12 | 90.36 | 寄往呼市办公室 | https://item.taobao.com/item.htm?spm=a1z09.2.0.0.8d0e2e8dCPAP0W&id=658491635366&_u=i2mr66e4e37 | 已开
 | 18650锂电池保护板等 | 1 | 5A | 145.53 | 145.53 | 寄往呼市办公室 | https://item.taobao.com/item.htm?spm=a1z09.2.0.0.8d0e2e8dCPAP0W&id=617056113532&_u=i2mr66e6303 | 已开 | 开错
 | 铸铝防水壳体 | 1 | （裸壳）+卡具+2根IPEX转NK | 345 | 345 | 寄往呼市办公室 | https://item.taobao.com/item.htm?spm=a1z09.2.0.0.4acc2e8dhRLuoy&id=625369751753&_u=h2mr66e95b3 | 已开
 |  |  |  |  | 9230.95

Sheet: Sheet1
RFID_MainBoard_设计生产工具(2022.3.18).xls 兼容性报表
运行时间: 2022-3-18 10:26
如果工作簿以早期的文件格式保存或在早期版本的 Microsoft Excel 中打开，将无法使用下列功能。
轻微保真损失 | 发生次数 | 版本
所选文件格式不支持此工作簿中某些单元格或样式包含的格式。这些格式将被转换为最相近的可用格式。 | 8 | Excel 97-2003
