phoenix9668/Collector/(list of files, cad)

Other CAD files:
Doc/Collector Case Design/240×240×80mm case/R2041C-GY200511-10-10084-（底壳8孔腰型图纸）.dwg
Doc/Collector Case Design/268×268×65mm case/R2327LK3底壳图纸.dwg
Doc/Collector Case Design/268×268×65mm case/R2327LK3盖板图纸.dwg
