phoenix9668/Collector/Doc/Production Process/Collector生产组装流程.docx

# RFID_CC1101_433MHz_V2生产组装流程

## 1，准备物料

1， 下载线ST-Link，转接板，下载夹具，通过连接线连接如下：

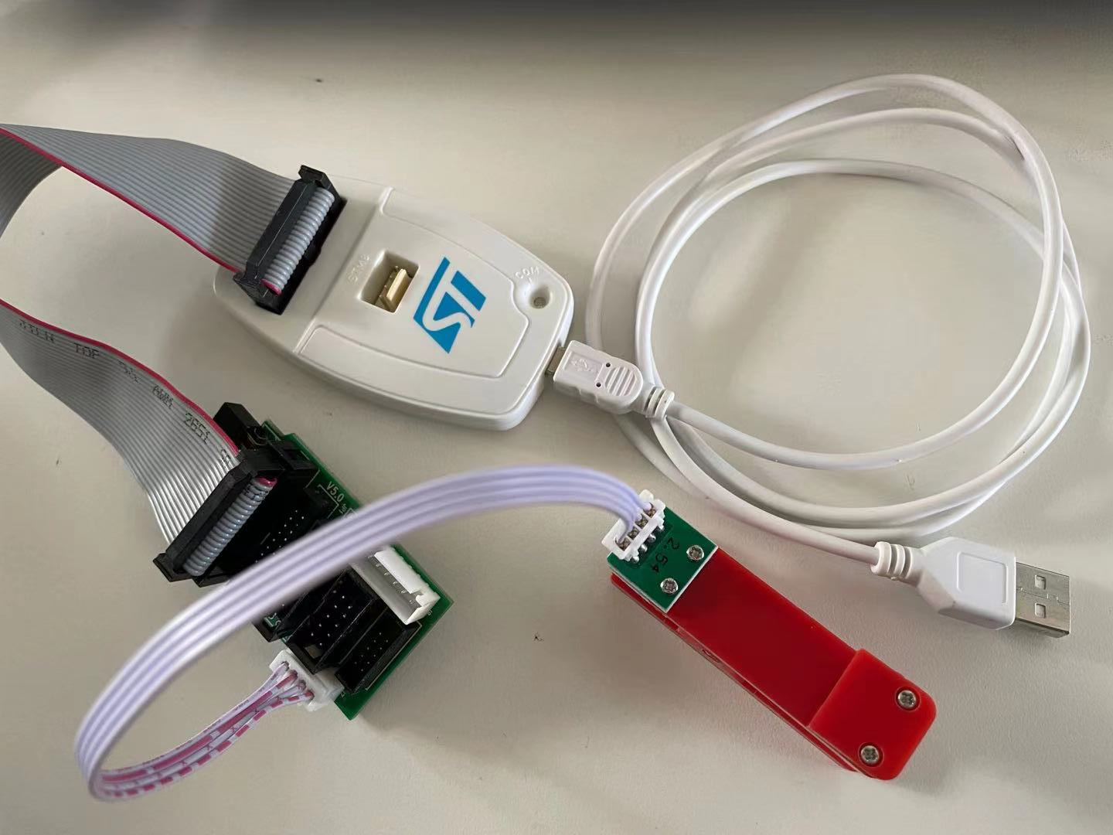
[picture p13: figure]

PCB夹具连接表如下：

表格 1

转接板4PIN插座连接点丝印 | 电路板P2连接点丝印
GND | GND
SWCLK | DP
SWDIO | DM

2， 配置串口线，下载夹具，通过连接线连接如下：

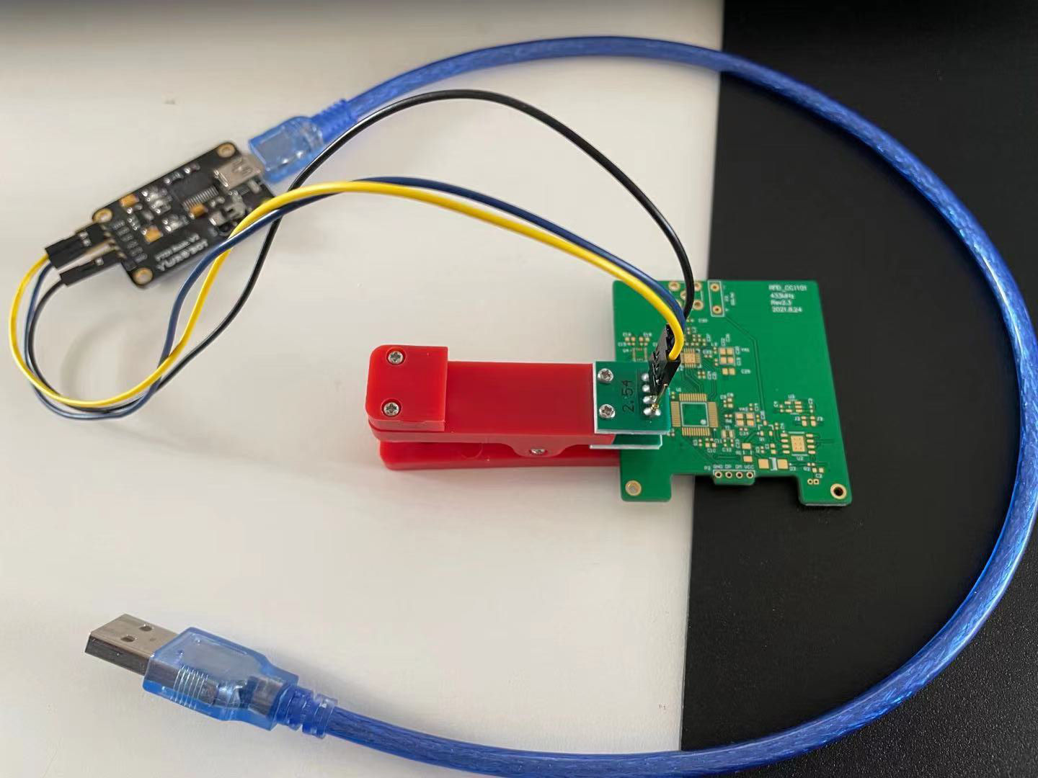
[picture p14: figure]

PCB夹具连接表如下：

表格 2

串口板连接点丝印 | 电路板P1接点丝印
GND | GND
TXD | TX1
RXD | RX1

3， 配置产品信息程序文件RFID_CC1101_433MHz_V2_Configure.axf；
4， 产品最终程序文件RFID_CC1101_433MHz_V2.axf；
5， 下载单片机程序软件STM32CubeProgrammer；
6， 产品信息烧写软件DeviceWriteExcelToolsV2.0以及产品信息文件《RFID项圈产品编号.xlsx》；

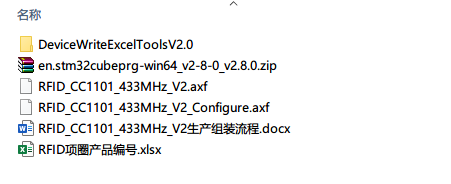
[picture p15: figure]

## 2，安装程序下载软件及下载线

1， 解压并安装STM32CubeProgrammer软件，安装过程全部默认即可；
2， 电脑USB口插入下载线ST-Link;
3， 使用另一端PCB夹具夹住电路板相应触电，如下图所示（按照表格 1所示连接，我这里没有3pin夹具，图片只能演示，另P2孔是2.2间距，夹具是2.54间距，所以不能完全对齐，但可以接触上）：

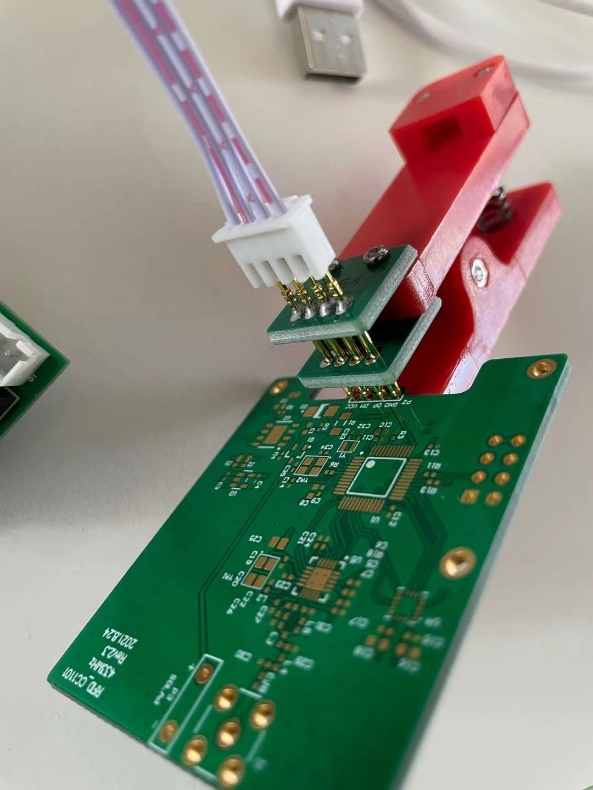
[picture p16: figure]

4， 双击STM32CubeProgrammer打开下载软件；

软件界面如下，如果如图中所示软件已自动扫描出ST-Link的串码，则说明下载线已被识别，如果软件没有自动识别出串码，需要手动点击刷新按钮，刷出串码，如果点击后无效，说明下载线没有被识别，需检查硬件；

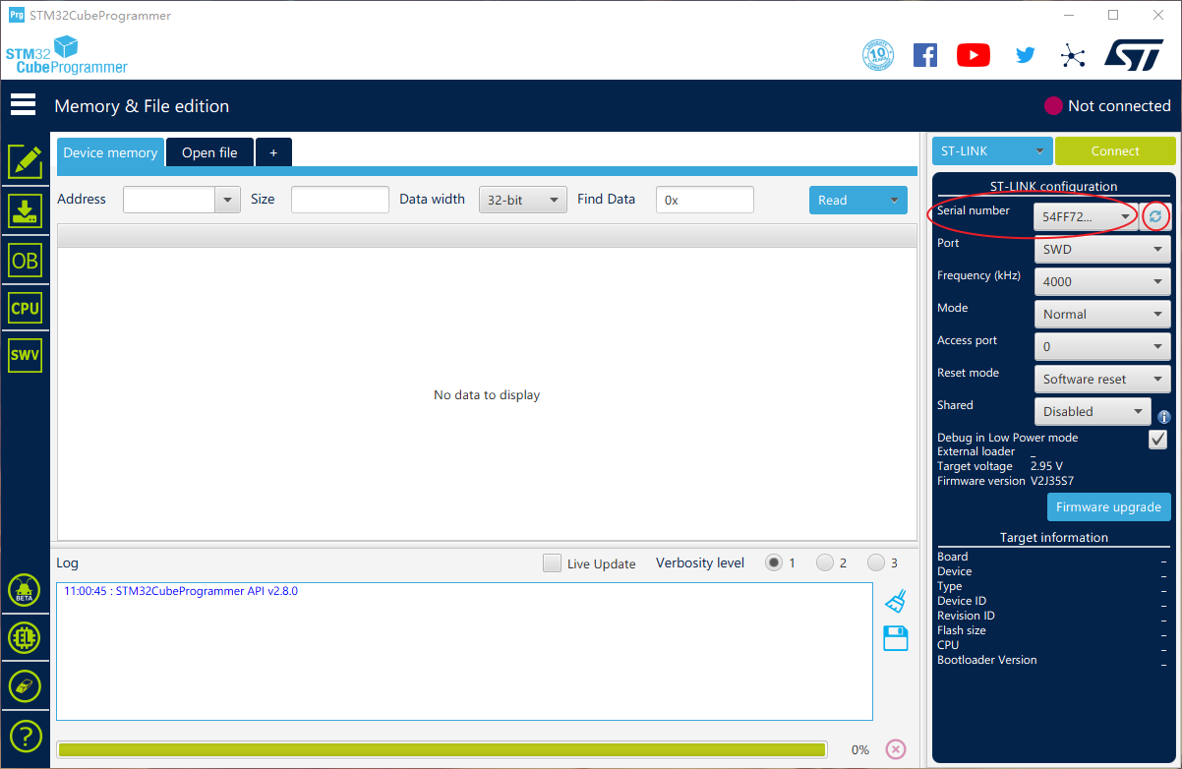
[picture p17: figure]

5， 按下图所示顺序点击，选择擦除和编程；

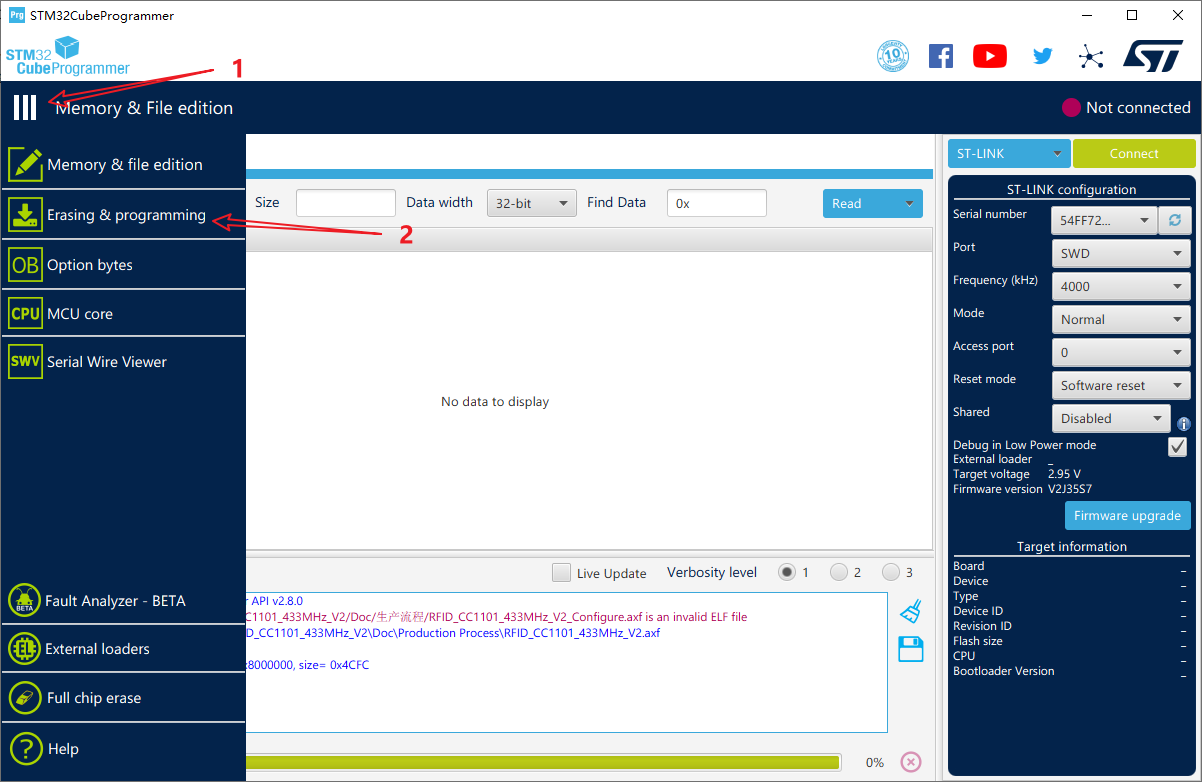
[picture p18: figure]

6， 按下图所示顺序点击，第1步在文件管理器（路径中不允许出现中文）中找到RFID_CC1101_433MHz_V2_Configure.axf程序文件并加载，第2步点击Connect，连接下载器（此步骤可在打开软件时就执行）；

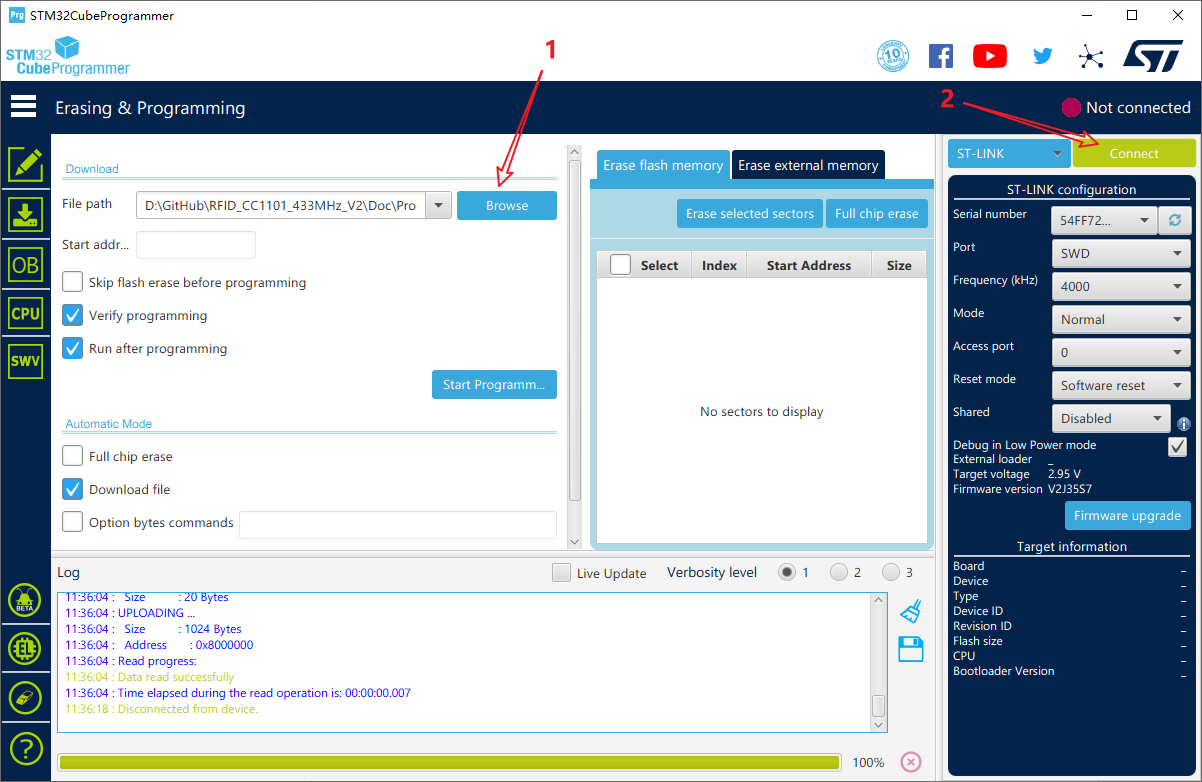
[picture p19: figure]

7， 完成上述步骤后，当出现标号1所示状态时（无法Connected请重启软件并插拔ST-Link），表示已与单片机建立连接，第2步点击Start Programming开始下载程序，经过一系列擦除编程操作，当出现3所示成功标志时，即完成下载；

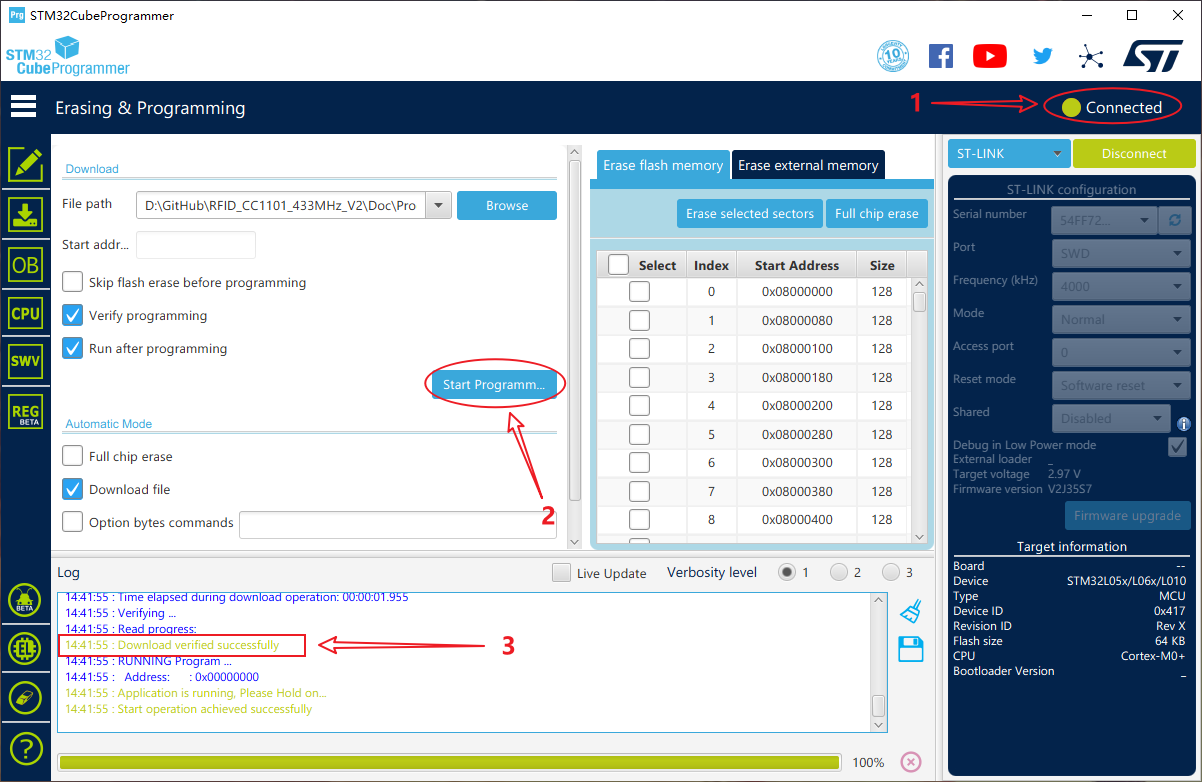
[picture p20: figure]

8， 手指按电路板上复位按键，此时观察电路板LED指示灯，出现两次慢闪后一直快闪，即表示程序和硬件都没有问题，如果开始没有两次慢闪，说明硬件有问题，初始化失败，此时拔掉电池，等待10秒，插上电池，如果仍然没有两次慢闪，此板可做坏板处理（先搁置）；
9， 如果LED指示灯无异常现象，进入下一步配置产品信息。

## 3，配置产品信息

1， 电脑USB口插入串口线；
2， 打开电脑设备管理器，找到串口线的端口号，如下图；

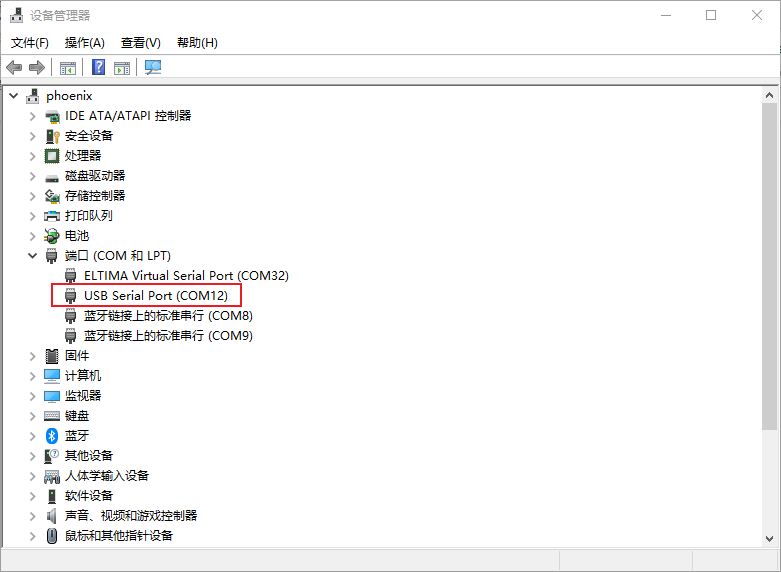
[picture p21: figure]

=

3， 打开DeviceWriteExcelToolsV2.0文件夹下的config.txt文件；

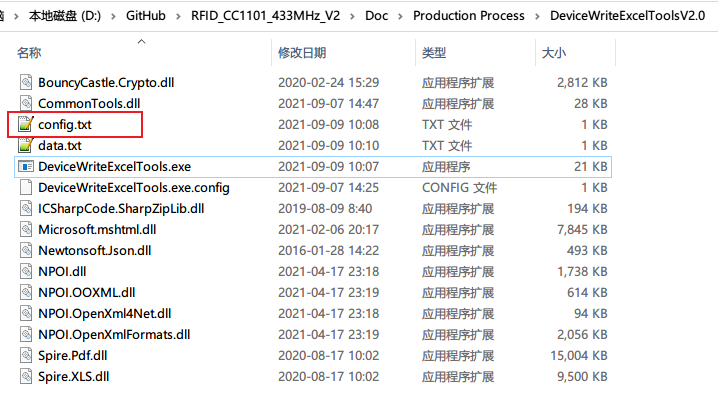
[picture p22: figure]

4， 修改为串口线对应的端口号，如com12修改如下图，修改完后保存并关闭配置文件；
5， 双击打开DeviceWriteExcelTools.exe软件，如端口修改正确，会打来相应端口号；
6， 使用串口线另一端PCB夹具夹住电路板相应触电，如下图所示（按照表格 2所示连接，夹到P1的1、3、5脚）

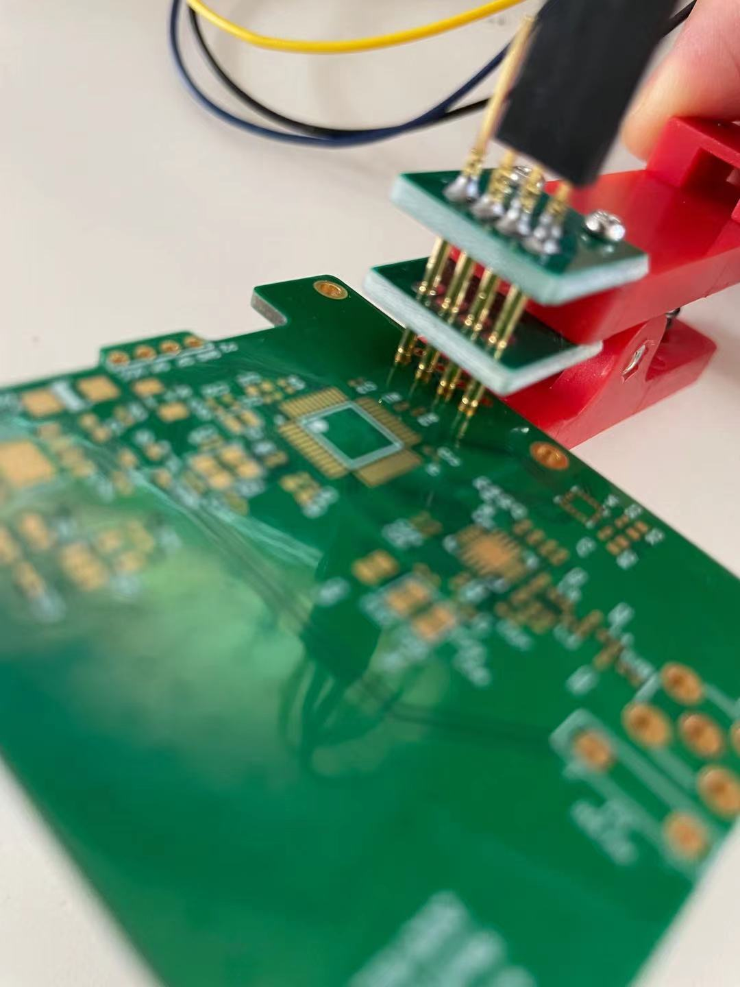
[picture p23: figure]

7， 此时可以按电路板上复位按键，如果在信息显示窗口中显示回传信息，说明PCB夹具安装正确；

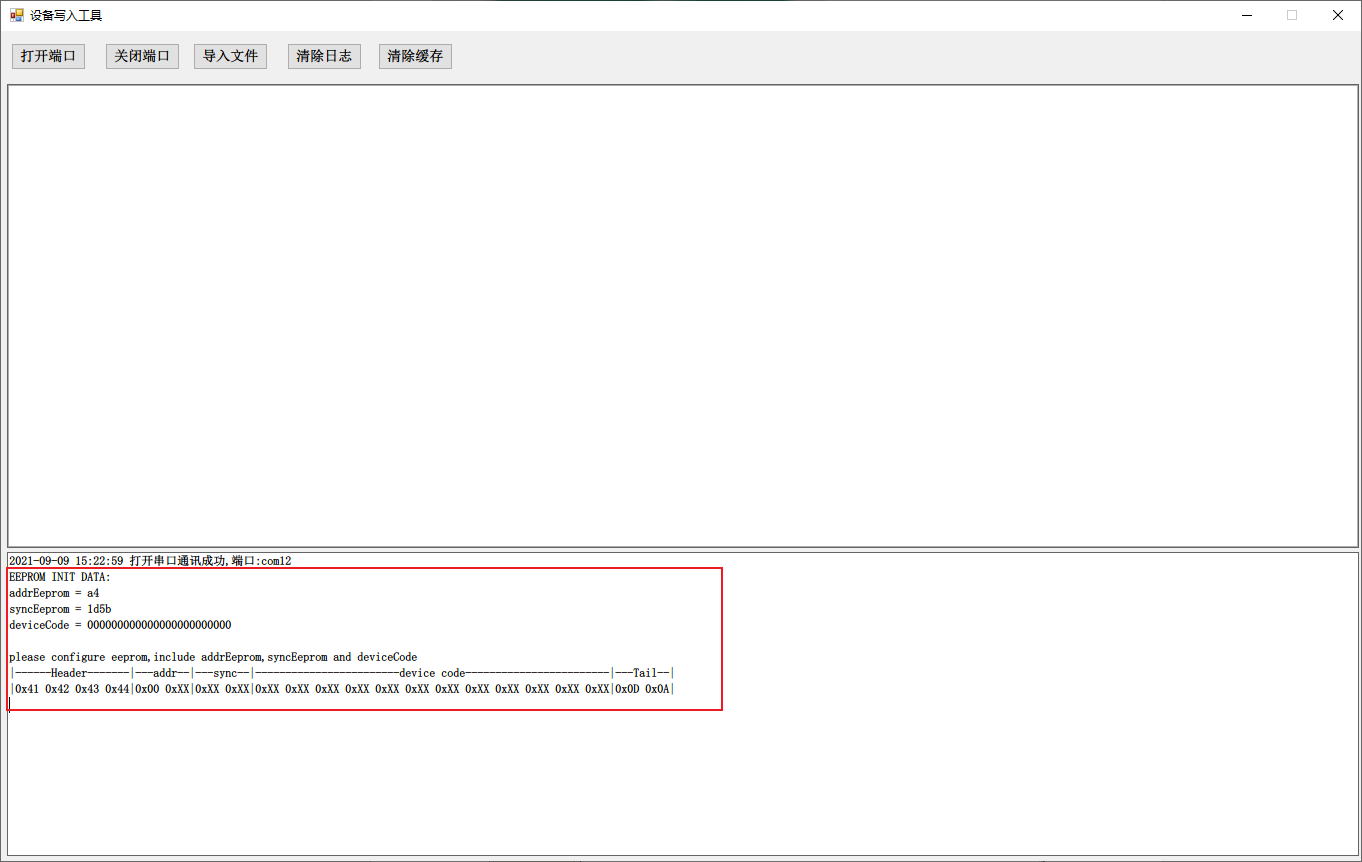
[picture p24: figure]

8， 点击设备写入工具的导入文件按钮，在文件管理器中选中《RFID项圈产品编号.xlsx》，加载产品信息；

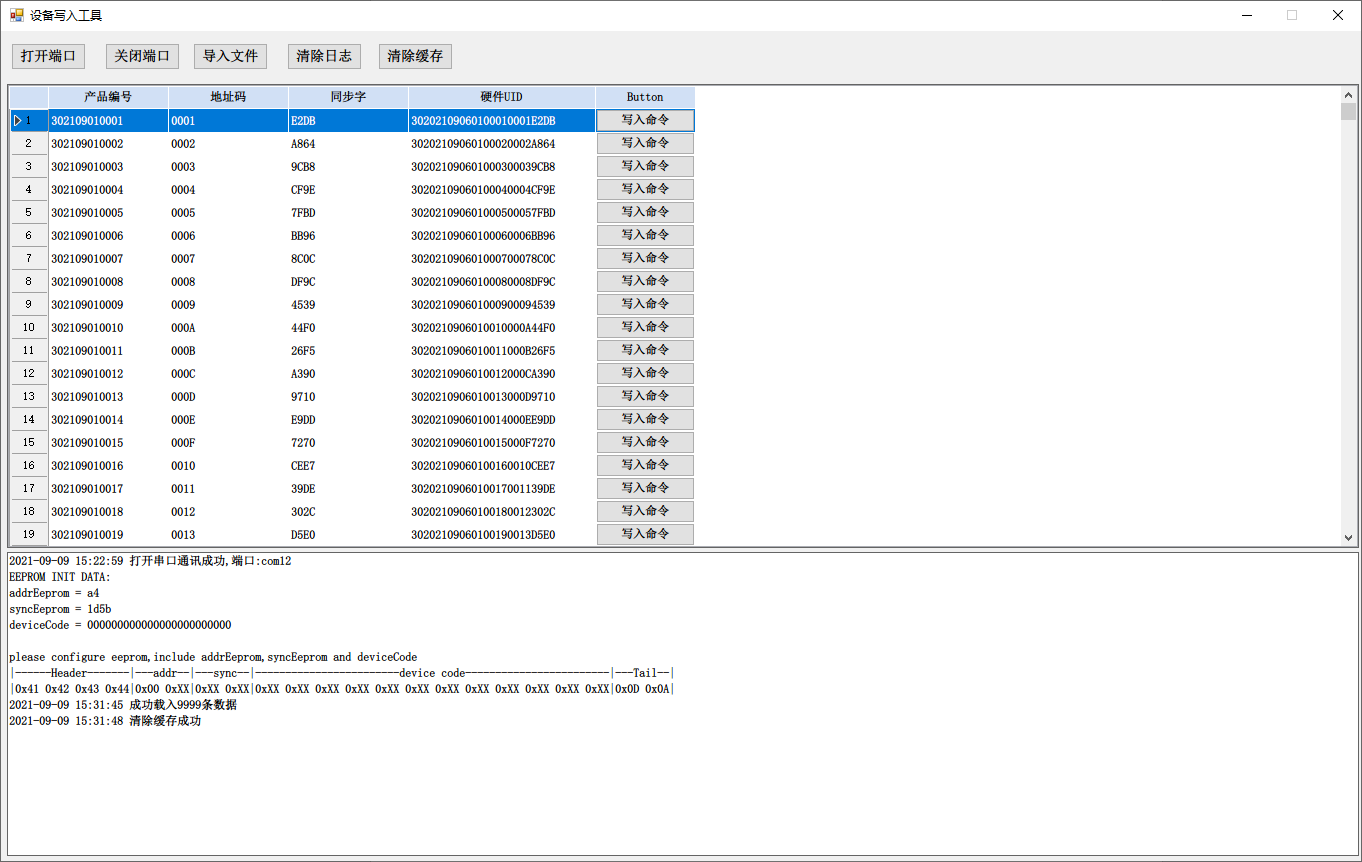
[picture p25: figure]

9， 找到想要写入的产品信息的一行，点击写入命令按钮，如果正确写入，写入命令按钮会变成已完成，信息窗口也会打印产品信息，只要显示已完成，即配置完成，同时此行产品信息背景变红并锁定，不允许再使用；

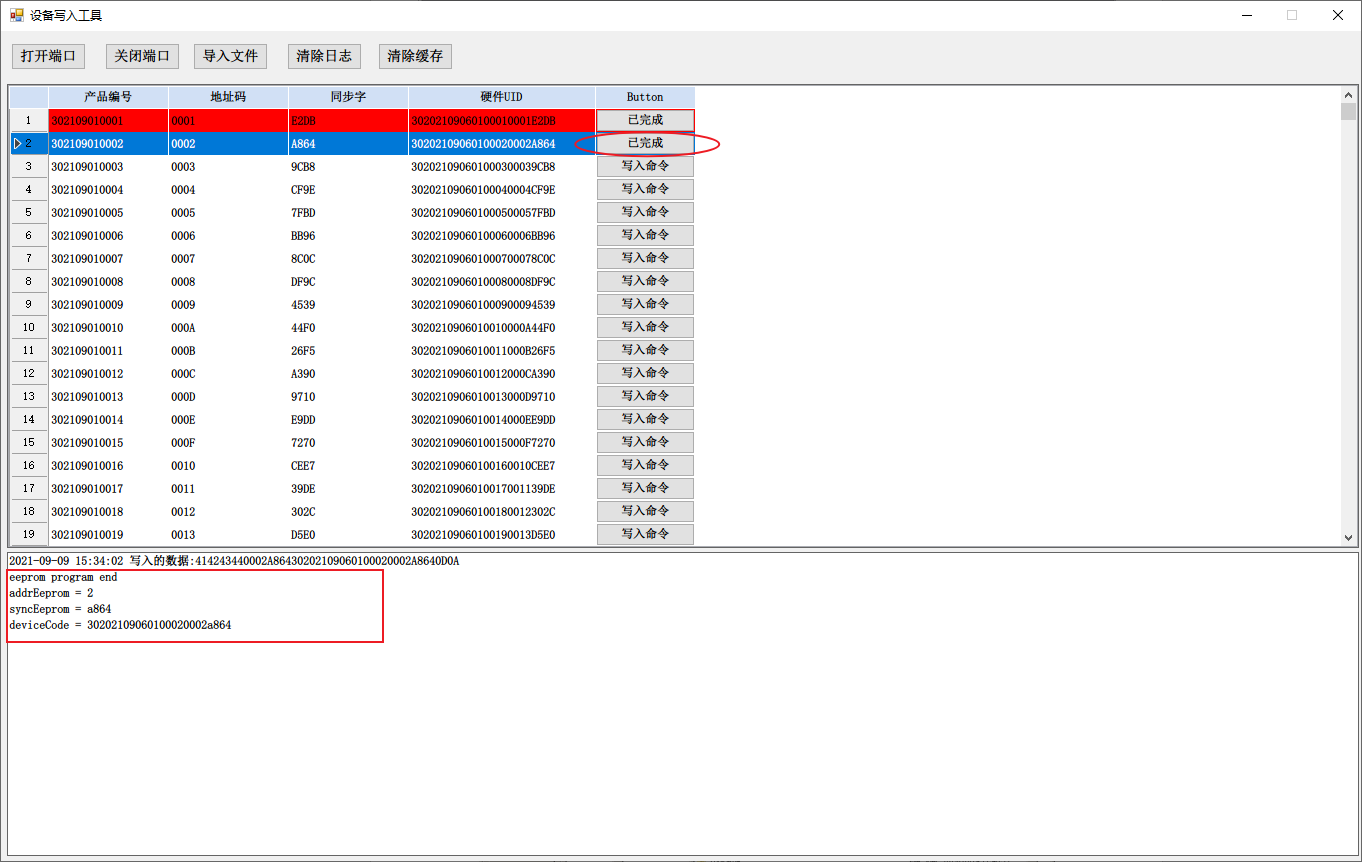
[picture p26: figure]

PS：DeviceWriteExcelTools.exe软件中的‘清除缓存’按钮可以将选中的锁定状态的一行信息解锁，此功能只允许在操作失误的情况下使用！

## 4，下载最终程序

下载步骤同2，安装程序下载软件及下载线中的4，5，6，7，

只是6，中的下载的程序为最终程序RFID_CC1101_433MHz_V2.axf

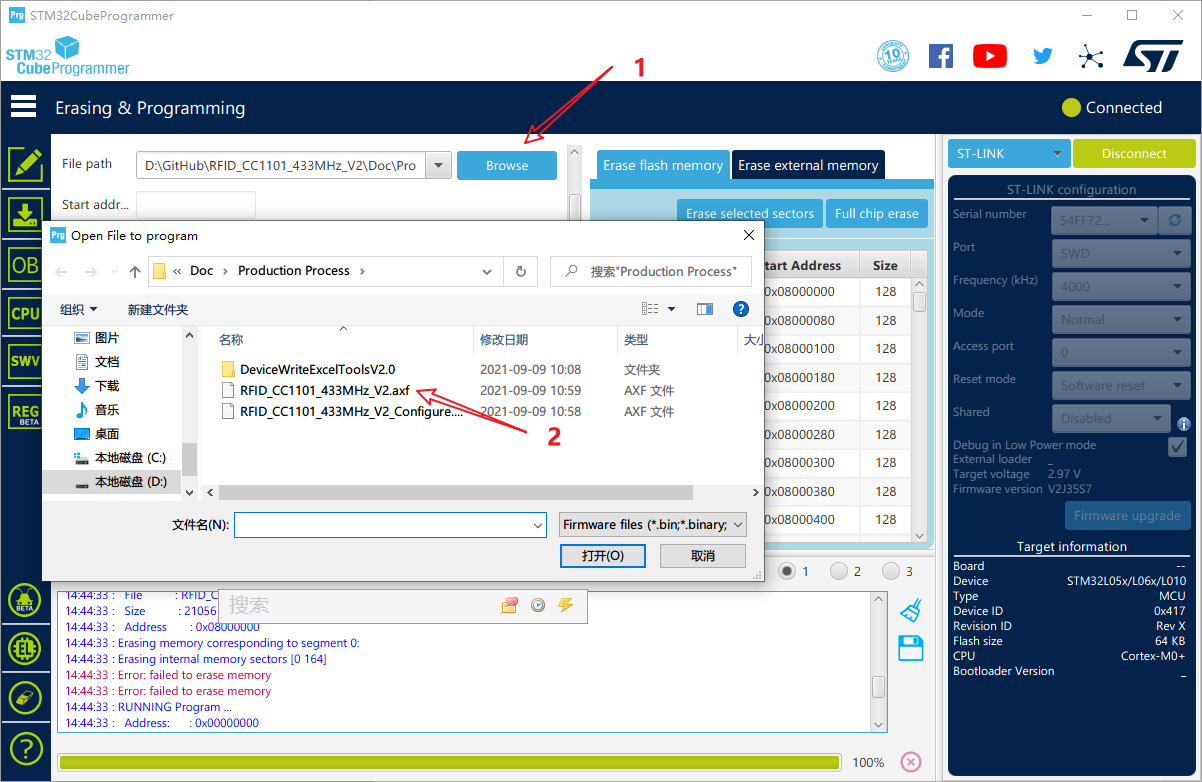
[picture p27: figure]

下载完成后，手指按电路板上复位按键，此时观察电路板LED指示灯，仅出现两次慢闪，即表示程序和硬件都没有问题。
