phoenix9668/Collector/Doc/Collector Case Design/240×240×80mm case/R2041C-GY200511-10-10084-（底壳8孔腰型图纸）.pdf

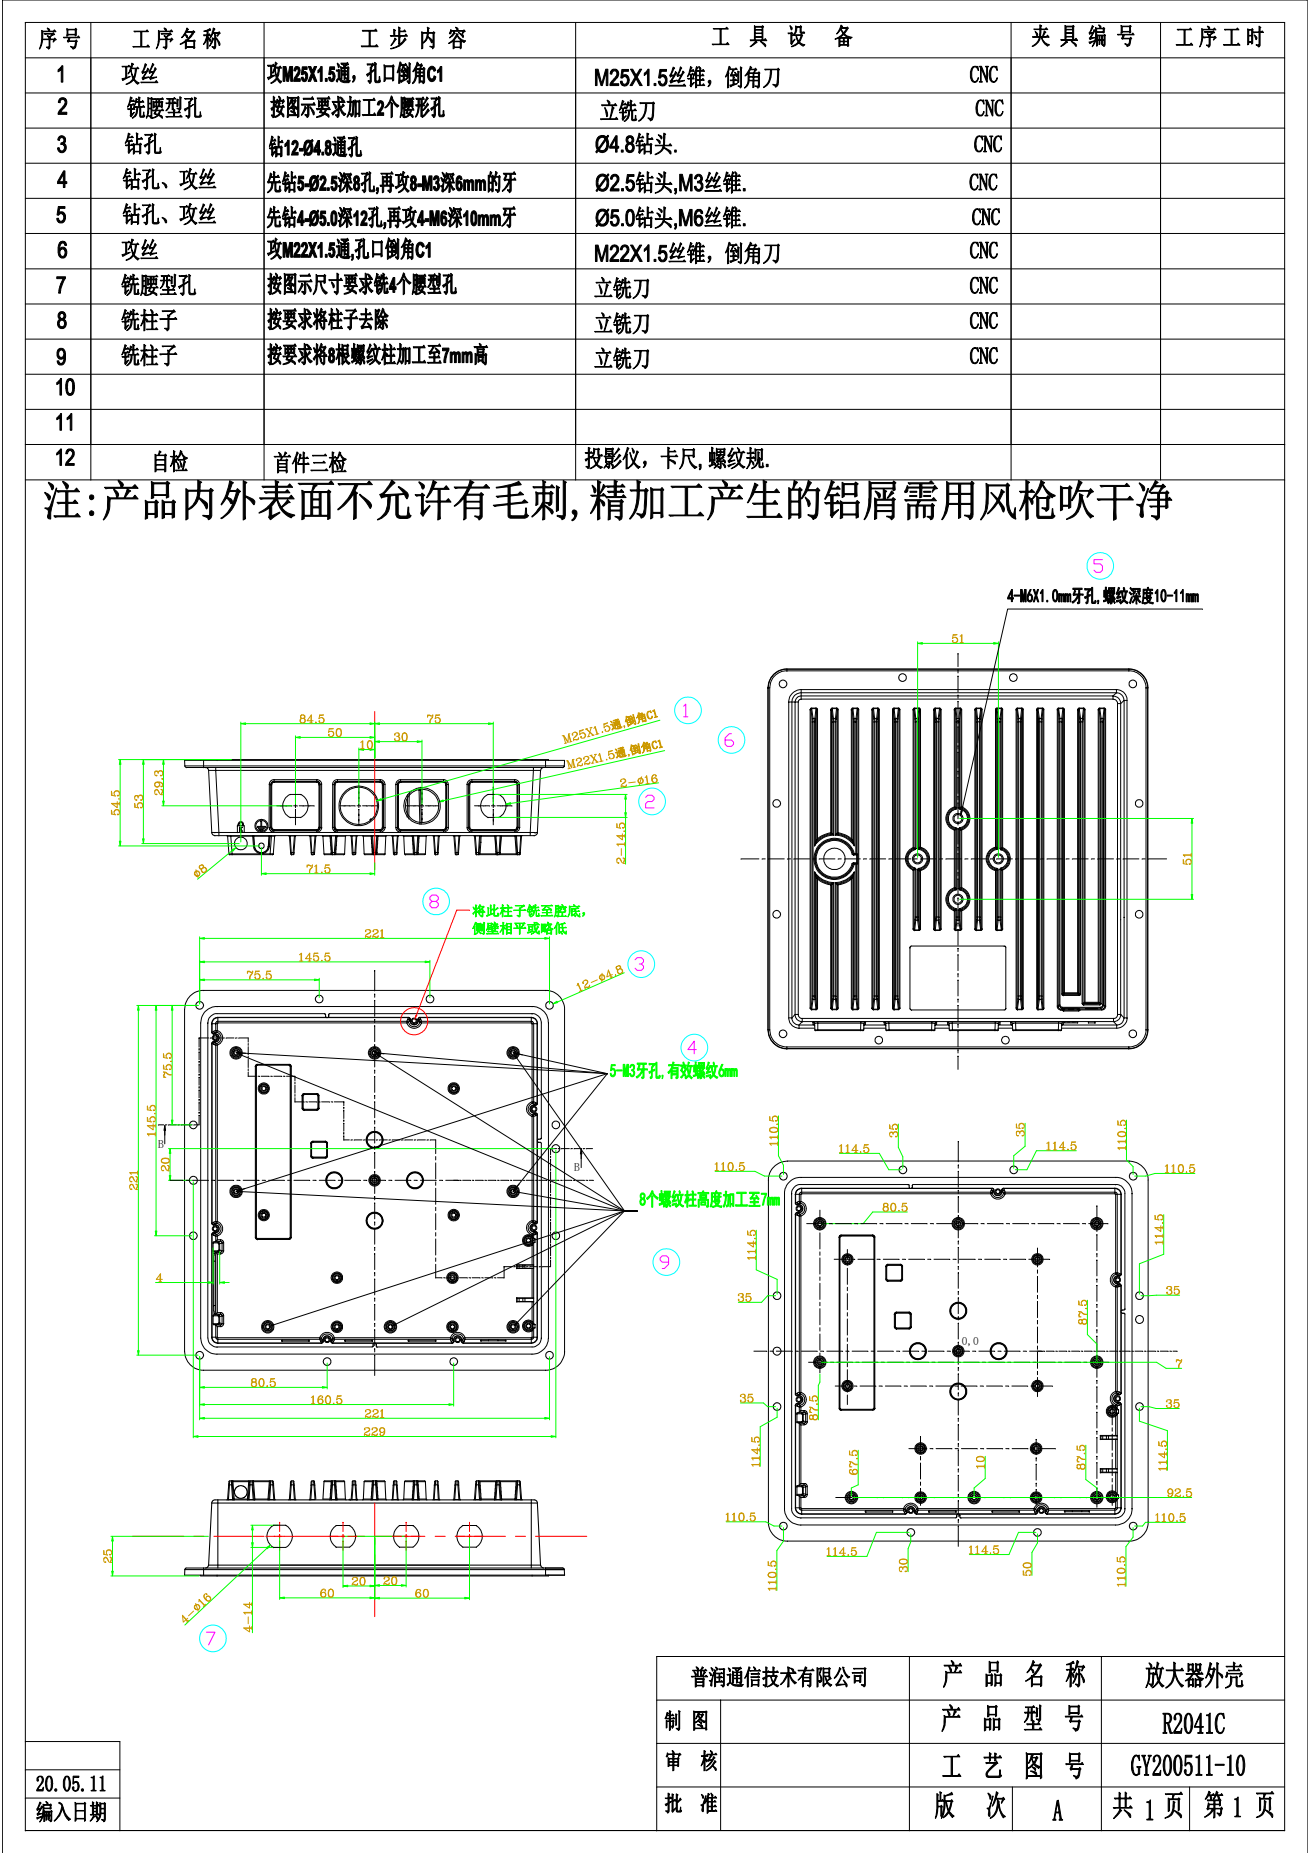
[picture p28: page 1]
