phoenix9668/Collector/Doc/Collector Case Design/268×268×65mm case/R2327LK3底壳图纸.pdf

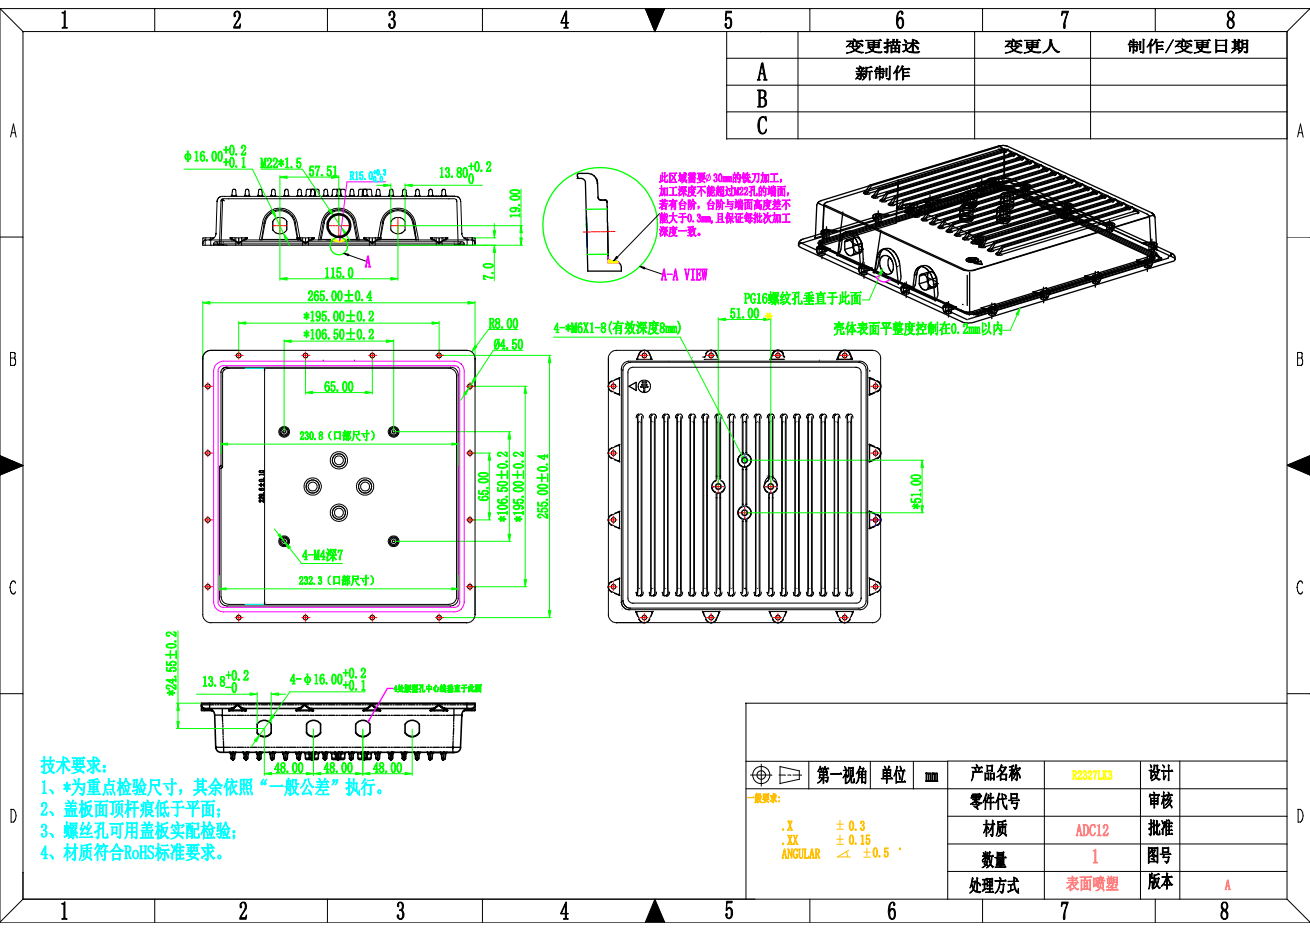
[picture p29: page 1]
