phoenix9668/Collector/Doc/Collector Case Design/268×268×65mm case/R2327LK3盖板图纸.pdf

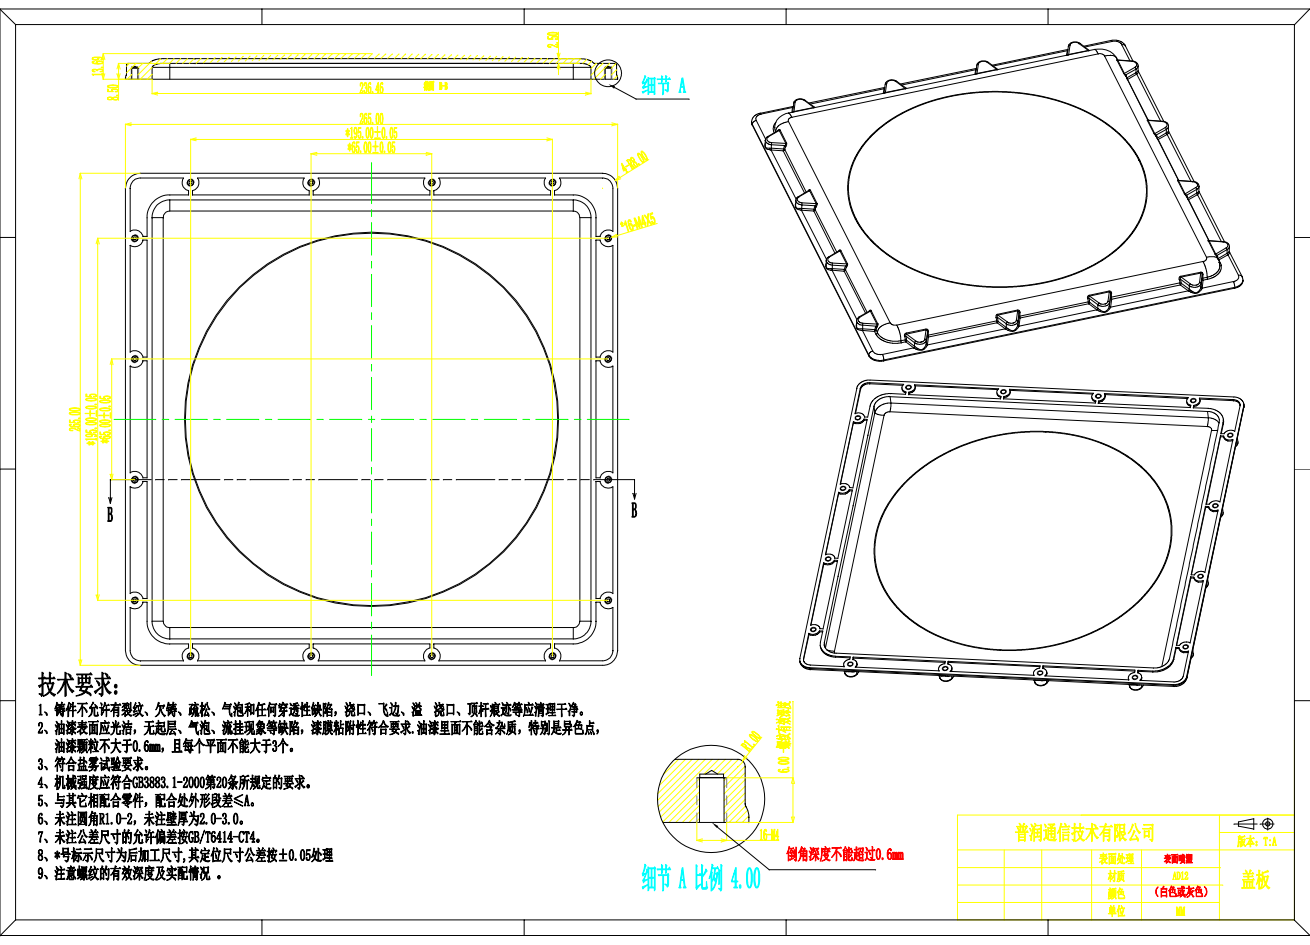
[picture p30: page 1]
