phoenix9668/Collector/Collector.ioc

Mcu.UserName=STM32L051C8Tx
PA1.GPIO_Label=TX_EN
PA1.Signal=GPIO_Output
PA10.Signal=USART1_RX
PA11.GPIO_Label=LED2
PA11.Signal=GPIO_Output
PA12.GPIO_Label=LED_GREEN
PA12.Signal=GPIO_Output
PA13.Signal=SYS_SWDIO
PA14.Signal=SYS_SWCLK
PA15.GPIO_Label=PA15
PA15.Signal=GPIO_Output
PA2.GPIO_Label=SPI1_CS
PA2.Signal=GPIO_Output
PA3.GPIO_Label=GDO0
PA3.Signal=GPXTI3
PA4.GPIO_Label=GDO2
PA4.Signal=GPXTI4
PA5.Signal=SPI1_SCK
PA6.Signal=SPI1_MISO
PA7.Signal=SPI1_MOSI
PA8.GPIO_Label=LED1
PA8.Signal=GPIO_Output
PA9.Signal=USART1_TX
PB10.Signal=LPUART1_TX
PB11.Signal=LPUART1_RX
PB2.GPIO_Label=RX_EN
PB2.Signal=GPIO_Output
PB3.GPIO_Label=USR4G_POWER_KEY
PB3.Signal=GPIO_Output
PB6.Signal=I2C1_SCL
PB7.Signal=I2C1_SDA
PB8.GPIO_Label=EC600X_RST
PB8.Signal=GPIO_Output
PC14-OSC32_IN.Signal=RCC_OSC32_IN
PC15-OSC32_OUT.Signal=RCC_OSC32_OUT
PH0-OSC_IN.Signal=RCC_OSC_IN
PH1-OSC_OUT.Signal=RCC_OSC_OUT
