phoenix9668/Collector/Core/Inc/main.h

#define EEPROM_START_ADDR   0x08080000   /* Start @ of user eeprom area */
#define TX_EN_Pin LL_GPIO_PIN_1
#define TX_EN_GPIO_Port GPIOA
#define SPI1_CS_Pin LL_GPIO_PIN_2
#define SPI1_CS_GPIO_Port GPIOA
#define GDO0_Pin LL_GPIO_PIN_3
#define GDO0_GPIO_Port GPIOA
#define GDO0_EXTI_IRQn EXTI2_3_IRQn
#define GDO2_Pin LL_GPIO_PIN_4
#define GDO2_GPIO_Port GPIOA
#define GDO2_EXTI_IRQn EXTI4_15_IRQn
#define RX_EN_Pin LL_GPIO_PIN_2
#define RX_EN_GPIO_Port GPIOB
#define LED1_Pin LL_GPIO_PIN_8
#define LED1_GPIO_Port GPIOA
#define LED2_Pin LL_GPIO_PIN_11
#define LED2_GPIO_Port GPIOA
#define LED_GREEN_Pin LL_GPIO_PIN_12
#define LED_GREEN_GPIO_Port GPIOA
#define PA15_Pin LL_GPIO_PIN_15
#define PA15_GPIO_Port GPIOA
#define USR4G_POWER_KEY_Pin LL_GPIO_PIN_3
#define USR4G_POWER_KEY_GPIO_Port GPIOB
#define EC600X_RST_Pin LL_GPIO_PIN_8
#define EC600X_RST_GPIO_Port GPIOB
