phoenix9668/Collector/Core/Inc/usart.h

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
/* Define to prevent recursive inclusion -------------------------------------*/
#ifndef __USART_H__
#define __USART_H__

#ifdef __cplusplus
extern "C" {
#endif

/* Includes ------------------------------------------------------------------*/
#include "main.h"

/* USER CODE BEGIN Includes */
#include "lwrb.h"
/* USER CODE END Includes */

/* USER CODE BEGIN Private defines */
//##################################################################################################################
#define _LTE_LPUART        LPUART1
#define _EC600X_USART      USART1
#define	_EC600X_RXSIZE     128     //  EC600X-command rx buffer size
#define	_EC600X_RBSIZE     256     //  EC600X-command ring buffer size
//##################################################################################################################
/**
 * \brief           Calculate length of statically allocated array
 */
#define ARRAY_LEN(x)       (sizeof(x) / sizeof((x)[0]))
//##################################################################################################################
/**
 * \brief           USART RX buffer for DMA to transfer every received byte RX
 * \note            Contains raw data that are about to be processed by different events
 */
extern uint8_t ec600x_usart_rx_dma_buffer[_EC600X_RXSIZE];

/**
 * \brief           Ring buffer instance for RX data
 */
extern lwrb_t ec600x_usart_rx_rb;

/**
 * \brief           Ring buffer data array for RX DMA
 */
extern uint8_t ec600x_usart_rx_rb_data[_EC600X_RBSIZE];

/**
 * \brief           Ring buffer instance for TX data
 */
extern lwrb_t ec600x_usart_tx_rb;

/**
 * \brief           Ring buffer data array for TX DMA
 */
extern uint8_t ec600x_usart_tx_rb_data[_EC600X_RBSIZE];

/**
 * \brief           Length of currently active TX DMA transfer
 */
extern volatile size_t ec600x_usart_tx_dma_current_len;

//##################################################################################################################
typedef struct
{
  uint8_t   rxBuffer[_EC600X_RXSIZE];
	uint8_t   rxHexBuffer[_EC600X_RXSIZE/2];
	uint16_t	rxCounter;
}lte_t;

extern lte_t lte;
//##################################################################################################################
/* USER CODE END Private defines */

void MX_LPUART1_UART_Init(void);
void MX_USART1_UART_Init(void);

/* USER CODE BEGIN Prototypes */
/* USART related functions */
void Enable_LPUART1(void);
void ec600x_usart_init(void);
void ec600x_usart_deinit(void);
void ec600x_usart_rx_check(void);
void ec600x_usart_send_string(const char* str);
uint8_t ec600x_usart_start_tx_dma_transfer(void);
void ec600x_usart_send_data(const void* data, size_t len);

void lte_lpuart_send_data(const void* data, size_t len);
void lte_lpuart_send_string(const char* str);

/* USER CODE END Prototypes */

#ifdef __cplusplus
}
#endif

#endif /* __USART_H__ */
