phoenix9668/Collector/Core/Src/rtc.c

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
/* Includes ------------------------------------------------------------------*/
#include "rtc.h"

RTC_HandleTypeDef hrtc;

/* RTC init function */
void MX_RTC_Init(void)
{

  RTC_TimeTypeDef sTime = {0};
  RTC_DateTypeDef sDate = {0};

  /** Initialize RTC Only
  */
  hrtc.Instance = RTC;
  hrtc.Init.HourFormat = RTC_HOURFORMAT_24;
  hrtc.Init.AsynchPrediv = 127;
  hrtc.Init.SynchPrediv = 255;
  hrtc.Init.OutPut = RTC_OUTPUT_DISABLE;
  hrtc.Init.OutPutRemap = RTC_OUTPUT_REMAP_NONE;
  hrtc.Init.OutPutPolarity = RTC_OUTPUT_POLARITY_HIGH;
  hrtc.Init.OutPutType = RTC_OUTPUT_TYPE_OPENDRAIN;
  if (HAL_RTC_Init(&hrtc) != HAL_OK)
  {
    Error_Handler();
  }

  /** Initialize RTC and set the Time and Date
  */
  sTime.Hours = 0;
  sTime.Minutes = 0;
  sTime.Seconds = 0;
  sTime.DayLightSaving = RTC_DAYLIGHTSAVING_NONE;
  sTime.StoreOperation = RTC_STOREOPERATION_RESET;
  if (HAL_RTC_SetTime(&hrtc, &sTime, RTC_FORMAT_BIN) != HAL_OK)
  {
    Error_Handler();
  }
  sDate.WeekDay = RTC_WEEKDAY_MONDAY;
  sDate.Month = RTC_MONTH_JANUARY;
  sDate.Date = 1;
  sDate.Year = 0;

  if (HAL_RTC_SetDate(&hrtc, &sDate, RTC_FORMAT_BIN) != HAL_OK)
  {
    Error_Handler();
  }
}

void HAL_RTC_MspInit(RTC_HandleTypeDef* rtcHandle)
{

  if(rtcHandle->Instance==RTC)
  {
    /* RTC clock enable */
    __HAL_RCC_RTC_ENABLE();
  }
}

void HAL_RTC_MspDeInit(RTC_HandleTypeDef* rtcHandle)
{

  if(rtcHandle->Instance==RTC)
  {
    /* Peripheral clock disable */
    __HAL_RCC_RTC_DISABLE();
  }
}

/* USER CODE BEGIN 1 */

void GetRTC(uint8_t *timeBuffer, uint8_t *dateBuffer)
{
    RTC_TimeTypeDef sTime = {0};
    RTC_DateTypeDef sDate = {0};

    HAL_RTC_GetTime(&hrtc, &sTime, RTC_FORMAT_BIN);
    HAL_RTC_GetDate(&hrtc, &sDate, RTC_FORMAT_BIN);

    timeBuffer[0] = sTime.Hours;
    timeBuffer[1] = sTime.Minutes;
    timeBuffer[2] = sTime.Seconds;
    dateBuffer[3] = sDate.WeekDay;
    dateBuffer[1] = sDate.Month;
    dateBuffer[2] = sDate.Date;
    dateBuffer[0] = sDate.Year;

    debug_printf("%02d/%02d/%02d ", 2000 + sDate.Year, sDate.Month, sDate.Date);
    debug_printf("%02d:%02d:%02d\n", sTime.Hours, sTime.Minutes, sTime.Seconds);
}

void SetRTC(uint8_t *timeBuffer, uint8_t *dateBuffer)
{
    RTC_TimeTypeDef sTime = {0};
    RTC_DateTypeDef sDate = {0};
    /** Initialize RTC and set the Time and Date
    */
    sTime.Hours = timeBuffer[0];
    sTime.Minutes = timeBuffer[1];
    sTime.Seconds = timeBuffer[2];
    sTime.DayLightSaving = RTC_DAYLIGHTSAVING_NONE;
    sTime.StoreOperation = RTC_STOREOPERATION_RESET;

    if (HAL_RTC_SetTime(&hrtc, &sTime, RTC_FORMAT_BIN) != HAL_OK)
    {
        Error_Handler();
    }

    sDate.WeekDay = dateBuffer[3];
    sDate.Month = dateBuffer[1];
    sDate.Date = dateBuffer[2];
    sDate.Year = dateBuffer[0];

    if (HAL_RTC_SetDate(&hrtc, &sDate, RTC_FORMAT_BIN) != HAL_OK)
    {
        Error_Handler();
    }
}

/* USER CODE END 1 */
