phoenix9668/Collector/Core/Src/spi.c

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
/* Includes ------------------------------------------------------------------*/
#include "spi.h"

/* SPI1 init function */
void MX_SPI1_Init(void)
{

  LL_SPI_InitTypeDef SPI_InitStruct = {0};

  LL_GPIO_InitTypeDef GPIO_InitStruct = {0};

  /* Peripheral clock enable */
  LL_APB2_GRP1_EnableClock(LL_APB2_GRP1_PERIPH_SPI1);

  LL_IOP_GRP1_EnableClock(LL_IOP_GRP1_PERIPH_GPIOA);
  /**SPI1 GPIO Configuration
  PA5   ------> SPI1_SCK
  PA6   ------> SPI1_MISO
  PA7   ------> SPI1_MOSI
  */
  GPIO_InitStruct.Pin = LL_GPIO_PIN_5;
  GPIO_InitStruct.Mode = LL_GPIO_MODE_ALTERNATE;
  GPIO_InitStruct.Speed = LL_GPIO_SPEED_FREQ_VERY_HIGH;
  GPIO_InitStruct.OutputType = LL_GPIO_OUTPUT_PUSHPULL;
  GPIO_InitStruct.Pull = LL_GPIO_PULL_NO;
  GPIO_InitStruct.Alternate = LL_GPIO_AF_0;
  LL_GPIO_Init(GPIOA, &GPIO_InitStruct);

  GPIO_InitStruct.Pin = LL_GPIO_PIN_6;
  GPIO_InitStruct.Mode = LL_GPIO_MODE_ALTERNATE;
  GPIO_InitStruct.Speed = LL_GPIO_SPEED_FREQ_VERY_HIGH;
  GPIO_InitStruct.OutputType = LL_GPIO_OUTPUT_PUSHPULL;
  GPIO_InitStruct.Pull = LL_GPIO_PULL_NO;
  GPIO_InitStruct.Alternate = LL_GPIO_AF_0;
  LL_GPIO_Init(GPIOA, &GPIO_InitStruct);

  GPIO_InitStruct.Pin = LL_GPIO_PIN_7;
  GPIO_InitStruct.Mode = LL_GPIO_MODE_ALTERNATE;
  GPIO_InitStruct.Speed = LL_GPIO_SPEED_FREQ_VERY_HIGH;
  GPIO_InitStruct.OutputType = LL_GPIO_OUTPUT_PUSHPULL;
  GPIO_InitStruct.Pull = LL_GPIO_PULL_NO;
  GPIO_InitStruct.Alternate = LL_GPIO_AF_0;
  LL_GPIO_Init(GPIOA, &GPIO_InitStruct);

  SPI_InitStruct.TransferDirection = LL_SPI_FULL_DUPLEX;
  SPI_InitStruct.Mode = LL_SPI_MODE_MASTER;
  SPI_InitStruct.DataWidth = LL_SPI_DATAWIDTH_8BIT;
  SPI_InitStruct.ClockPolarity = LL_SPI_POLARITY_LOW;
  SPI_InitStruct.ClockPhase = LL_SPI_PHASE_1EDGE;
  SPI_InitStruct.NSS = LL_SPI_NSS_SOFT;
  SPI_InitStruct.BaudRate = LL_SPI_BAUDRATEPRESCALER_DIV2;
  SPI_InitStruct.BitOrder = LL_SPI_MSB_FIRST;
  SPI_InitStruct.CRCCalculation = LL_SPI_CRCCALCULATION_DISABLE;
  SPI_InitStruct.CRCPoly = 7;
  LL_SPI_Init(SPI1, &SPI_InitStruct);
  LL_SPI_SetStandard(SPI1, LL_SPI_PROTOCOL_MOTOROLA);
}

/* USER CODE BEGIN 1 */
//##################################################################################################################
/**
  * @brief  This function Activate SPI2
  * @param  None
  * @retval None
  */
void Activate_SPI(void)
{
    /* Enable SPI1 */
    LL_SPI_Enable(SPI1);
}
//##################################################################################################################
uint8_t SPI_ExchangeByte(uint8_t input)
{
    LL_SPI_TransmitData8(SPI1, input);

    while (!LL_SPI_IsActiveFlag_TXE(SPI1)) {};

    while (!LL_SPI_IsActiveFlag_RXNE(SPI1)) {};

    return (LL_SPI_ReceiveData8(SPI1));
}
//##################################################################################################################
// Function for sending and receiving data through SPI
void SpiFunction(uint8_t *OutputBuff, uint8_t *InputBuff, uint16_t OutNoOfBytes, uint16_t InNoOfBytes)
{
    for(uint16_t i = 0; i < OutNoOfBytes; i++)
    {
        SPI_ExchangeByte(OutputBuff[i]);					// Send data
    }

    for(uint16_t i = 0; i < InNoOfBytes; i++)
    {
        InputBuff[i] = SPI_ExchangeByte(0xFF);		// Receive data
    }
}
//##################################################################################################################
/* USER CODE END 1 */
