phoenix9668/Collector/(commit log)

2017-11-03 初始版本
    通过串口输入输出实现两个cc1101的通信
2017-11-03 Create README.md
    使用描述
2017-11-03 上传Doc和Listing文件夹
2017-11-16 Add Address Filtering
    增加地址滤波功能，修改地址检测方式为ADR_CHK = Address check and 0 (0x00) and 255 (0xFF) broadcast，即开启地址滤波，当数据包中的地址和接收芯片的地址不一致时数据抛弃；但当数据包中的地址为 0 (0x00) and 255 (0xFF)时，是广播模式，所有芯片接收。
2017-11-20 修改cc1101配置
    Carrier frequency = 432.999817mHz,Data rate = 76.767kBaud,Whitening = ture,Manchester enable = ture ,RX filter BW = 232.142857kHz,Modulation format = 2-FSK,Deviation = 31.738281kHz,Address config = Address check and 0 (0x00) and 255 (0xFF) broadcast,Packet length mode = Variable packet length mode.
2017-11-22 电磁波激活功能WOR
    调试成功电磁波激活功能，设置tEvent0 = 750/fXOSC * EVENT0 * 2^(5*WOR_RES) = 750/(26*10^6) * 36000 * 2^0 = 1.038s,tRXtimeout = tEvent0 * Duty cycle = 129.75ms,即接收搜索129.75ms后进入sleep状态，sleep状态持续大约tEvent0-tRXtimeout后再次进入接收，循环知道接收到数据。
    本程序连续发送100组数据，接收端每接收到一组数据后立即进入WOR状态。
    电流表实测接收电流17.72mA，sleep电流0.3uA。
    电磁波激活功能的详细配置参考AN047.pdf
2017-11-22 更新cc1101.c
    更新cc1101.c
2017-11-23 读取RSSI值，并计算得到绝对功率值
    增加int16_t CC1101ReadRSSI(void)和int16_t CC1101CalcRSSI_dBm(uint8_t rssi_dec)两个函数，第一个函数从状态寄存器0x34 (0xF4)中读出RSSI值，第二个函数将从数据包最后两个添加的寄存器中拿到的RSSI值转为绝对功率。
2017-11-24 增加acknowledge功能
    接收端收到数据，判断正确后回复发送端，发送端接收到acknowledge信息，证明整个流程完毕。
    如果没有收到acknowledge信息，发送端也会在TIM计数2s后退出整个流程。
2017-11-24 上传DN505
    DN505:RSSI Interpretation and Timing
2017-11-30 增加三轴加速度计MMA7361L逻辑
    增加bsp_adc.c和bsp_adc.h两个文件，用来初始化ADC1，ADC2，ADC3和DMA2，采用三重规则同时模式；
    增加void MMA7361L_ReadHandler(void)中断程序，每当定时器定时0.1s执行一次中断程序，唤醒MMA7361L并记录一次XYZ数据；
    十次记录数据存储在AckBuffer中，当发送数据一方请求数据时，接收方接收到命令后将AckBuffer发送给请求方；
    AckBuffer[3]的高4bit记录的是接收方发送AckBuffer时的CollectCnt，用来表示那组数据是最新数据。
2017-12-04 cc1101_ctrl_STD详细说明
    cc1101_ctrl_STD详细说明
2017-12-19 物联网采集卡主板代码说明
    物联网采集卡主板代码说明
2017-12-19 重建工程，修改工程名
    重建工程，目的是修改工程名
2017-12-28 根据RFID协议修改代码
    1.根据《物联网硬件平台-RFID通讯数据结构.pdf》修改代码
    2.将main.c中功能函数放在function.c中
    3.调试完成查询指定标签功能
2017-12-28 完成批量查询标签功能
    2.在查询指定标签功能基础上完成批量查询标签功能
    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
2018-01-12 修改RF_Initial参数
    RF_Initial(0x5, 0xD391, RX)改为RF_Initial(0x35, 0x4D5A, RX)
    RF_Initial(0x6, 0x8289, RX)改为
    RF_Initial(0x36, 0x6D7A, RX)
2018-01-12 更新《物联网硬件平台-RFID通讯数据结构.docx》
    更新《物联网硬件平台-RFID通讯数据结构.docx》
2018-01-29 调试FSMC接口失败
    1.增加bsp_fsmc.c和bsp_fsmc.h，包含fsmc接口初始化和基本读写擦函数，读取ID和状态函数；
    2.调试失败，可以读出ID，但是不明原因，下载程序后芯片经常读写保护，怀疑程序或软件版本有bug，待主要功能调完后继续调试。
2018-01-30 增加日历时钟功能
    1.增加日历时钟功能，按照协议可以设置日历时钟，和读取当前板卡的日历
    2.修改《物联网硬件平台-RFID通讯数据结构》，帧中增加日历时钟数据
    3.测试通过
    [Prj_MCU物联网平台开发计划.xlsx]
2018-02-27 修改标签发送数据帧长度为60的程序和协议
    1.标签发送数据帧长度增加为60，对应修改主板程序
    2.修改《物联网硬件平台-RFID通讯数据结构》
    3.增加GPRS简单配置代码
2018-02-28 增加上位编程标签地址码、同步码、RFID码功能
    1.增加上位编程标签地址码、同步码、RFID码功能
    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
2018-03-06 增加255bytes数据包传输功能
    1.增加小于256bytes数据包传输功能
    2.调试通过
    3.修改《物联网硬件平台-RFID通讯数据结构》协议
2018-03-19 使用EXTI中断实现RF接收发送功能
    1.修改RF接收发送功能，删除类似于while (CC1101_IRQ_READ() == 0);的通过判断外部引脚电平高低的方式来确实外部状态的逻辑，改为使用EXTI中断来处理CC1101的GDO0和GDO2引脚状态。
    2.修改CC1101RecPacket函数中 if(status[1] & CRC_OK){return pktLen;}
    else{return 0;}为if(status[1] & CRC_OK){return pktLen;}else{return 1;}，即当CRC不正确时，函数返回值为1。
    3.修改TIM_TimeBaseStructure.TIM_Period = 5-1; 为TIM_TimeBaseStructure.TIM_Period = 10000-1; 即定时时间间隔为1秒。
2018-04-25 新协议代码，只传输计步数据
    1.修改《物联网硬件平台-RFID通讯数据结构.docx》，标签的回传数据改为4bytes实际计步数据。
    2.代码做相应修改，RECV_LENGTH改为19，ACK_LENGTH改为27。
2018-05-03 修改全扫描和指定扫描逻辑
    1.修改全扫描和指定扫描的地址，同步字，标签编号信息从结构体中读取。
    2.测试全扫描功能，发现不能正常扫描完，前3，4个可以扫描出来，后面的没有反应。
2018-05-07 增加Ethernet功能
    1.调试使用W5500芯片实现TCP/IP协议以太网
    2.实现client功能，并集成在主程序中
2018-05-15 增加主板上RS232 COM口的配置代码
    1.增加COM1和COM2的USart配置代码
    2.使用MOD_USART调试GPRS模块通过，使用透传云正常收发
    3.尝试调试COM1和MOD_USART两个串口直接的透传失败，使用DMA实现，但是中断一直触发，官方代码也没有跑通，待有时间继续调试
2018-05-21 增加FRAM存储设备ID和RFID功能
    1.增加FM25L256-G芯片控制函数
    2.增加上位机读和写FRAM功能，即将ID信息存储在FRAM中，开机初始化设备ID和RFID_init结构体
2018-11-06 标签测试版Mark
    1.测试200个标签版程序
    2.做了一些小代码的优化，如增加RF_ProgPacket函数来编程RFID
2019-01-16 增加段内扫描功能
    1.增加0xA401命令和Check_Assign_Section_RFID(uint8_t *command);函数，执行段内扫面功能
    2.更新《物联网硬件平台-RFID通讯数据结构.docx》
2019-02-13 增加窗口看门狗
    1.程序增加wwdg功能，喂狗除了在SysTick_Handler中，主要在RF_SendPacket，RF_SendClearPacket，RF_ProgPacket，RF_Acknowledge这四个函数中；
    2.关闭TIMx_Configuration();函数及其中断；
    3.初步测试通过。
2019-02-22 优化看门狗逻辑，增加GPRS模块复位功能，增加回传数据量，增加上位配置ADXL362功能，增加PVD功能
    1.优化看门狗逻辑，删除TimingDelay == 1逻辑；
    2.增加GPRS模块复位功能，包括程序上电加载复位和24小时计时复位；
    3.修改计步数据为20分钟记录一个值，共存储12个值，共48bytes，即4小时的详细步数；
    4.增加上位机配置ADXL362参数的功能；
    5.增加PVD电压检测功能，设置阈值为2.8V，并将battery_low标志加入到回传数据中。
2022-01-09 Using freeRTOS
    RFID MainBoard code using freeRTOS on stm32f407.
    [Prj_MCU物联网平台开发计划.xlsx]
2022-01-10 use UART+DMA receive data
    1.use UART+DMA receive data；
    2.add cc1101.c and fram.c；
2022-01-11 complete usart rx idle line irq rtos function
    1.Complete DMA HT & TC + USART IDLE LINE IRQ + RTOS logic；
    2.Complete fram control logic；
2022-01-17 debug CC1101RecvHandler() logic and draw hardware protocol
    1.debug CC1101RecvHandler() logic；
    2.draw hardware protocol and upgrade program according to the hardware protocol;
2022-02-11 debug DMA interrupt stuck
    1.DMA interrupt stuck program, because using semaphore in DMA interrupt before freeRTOS init;
    2.add system reset by software;
    3.modify uLen debug;
    [fram.c, fram.h, main.c]
2022-03-14 add 新基站壳体设计相关文件
    1.add 基站壳体.drawio;
    2.add 铸铝防水机盒.dwg;
2022-03-18 add 新基站壳体尺寸文件
    [R2041C-GY200511-10-10084-（底壳8孔腰型图纸）.dwg, R2327LK3底壳图纸.dwg, R2327LK3盖板图纸.dwg, RFID_MainBoard_壳体(2022.3.17).xls, RFID_MainBoard_天线(2022.2.14).xls, RFID_MainBoard_设计生产工具(2022.3.18).xls]
2022-03-18 change name RFID_MainBoard to Collector
    [Collector壳体(2022.3.17).xls, Collector天线(2022.2.14).xls, Collector设计生产工具(2022.3.18).xls, R2041C-GY200511-10-10084-（底壳8孔腰型图纸）.dwg, R2327LK3底壳图纸.dwg, R2327LK3盖板图纸.dwg, RFID_MainBoard_壳体(2022.3.17).xls, RFID_MainBoard_天线(2022.2.14).xls]
2022-03-20 replacing the main control chip STM32F407VG to STM32L051C8
    1.replace HAL library;
    2.modify some logic.
    [Collector.ioc, cc1101.c, gpio.h, lptim.c]
2022-04-15 freeRTOS debugging completed
    1.freeRTOS debugging completed, reduce stack size;
    2.LPUART+DMA rx debugging completed, add Enable_LPUART1() and it must be at end of MX_FREERTOS_Init() function;
    3.ModuleLtePowerOn() function debugging completed, USR4G_POWER_KEY GPIO must be pull down;
2022-04-24 add usart ring buffer lib, i2c and sgm58031 driver
    1.add lwrb.c and lwrb,h, use ring buffer function;
    2.add hardware i2c function;
    3.add sgm58031 driver code;
    4.compile and debug successfully.
2022-05-23 add sgm58031 driver code
    1.add sgm58031 driver code;
    2.add I2C interface logic;
    2.add lptim logic;
    3.modify freertos logic.
2022-05-29 upgrade doc
    [Collector壳体(2022.3.17).xls, Collector壳体，电路板及配件(2022.5.27).xls, Collector天线(2022.2.14).xls, Collector设计生产工具(2022.3.18).xls]
2022-06-07 add CC1101 power control function
    1.add PA15 pin, CC1101_POWER_DOWN() and CC1101_POWER_ON() functions;
    2.modify HSE_VALUE = 8000000 to 12000000.
2022-07-04 use USART1 transmit-receive
    1.use USART1 transmit-receive replace LPUART1;
    2.add AsciiToHex function.
    [Collector.ioc, main.c, main.h, usart.c, usart.h]
2023-03-30 add FireWater function
    1.add FireWater function;
    2.modify RFIDInitial(0x00, 0x1234, RX_MODE) to RFIDInitial(0xEF, 0x1234, RX_MODE).
    [海康威视4G摄像头(2023.1.30).xls]
2024-06-13 开启SGM58031逻辑
    1.由于新的EC600U开发板的IIC接口读不回ADC芯片的数据，所以该用stm32芯片读，再转发给EC600U开发板；
    2.同事优化SGM58031逻辑，每20分钟各读取两个通道一次，将两个通道的数据组包发给EC600U。
    [Collector(体征监测基站)生产BOM.xls, Collector(体征监测基站)配件自锁开关.xls, Collector电路板及配件(2023.7.13).xls, Collector电路板及配件(2024.4.2)(10套).xls, Collector配件(2023.11.20).xls, 焊接工具及耗材(2023.11.20).xls]
2025-07-02 update document
    [4G模组和网络分析仪(2025.4.6).xls, Collector(体征监测基站)生产BOM((100套).xls, Collector(体征监测基站)生产BOM.xls, Collector国际版4G模组(2025.3.10).xls, Collector电路板及配件(2024.7.29)(20套)(补充).xls, Collector电路板及配件(2024.7.29)(20套).xls, 国际版4G模组(2025.4.21).xls, 工控机内存条采购.xls]
2025-07-02 修复usart1的dma rx功能，主要问题是dma的init函数要放在usart1的init函数之前
    1.修复usart1的dma rx功能，主要问题是dma的init函数要放在usart1的init函数之前，同时把LL_USART_Enable(USART1)放到整个初始化流程的最后；
    2.更新固件。
    [Collector.ioc, lwrb.c, main.c, main.h, usart.c]
2025-07-02 新增接收EC600X心跳包逻辑，并判断，心跳包周期为5分钟，12分钟内未接到心跳包则拉低PB8 500ms来重启EC600X
    1.freertos新增StartHeartbeatMonitorTask；
    2.StartUsartRxCmdTask监测心跳包，收到心跳包，重置心跳定时器；
    3.StartHeartbeatMonitorTask判断12分钟内有没有收到心跳包，如果超时，则重启EC600X。
2025-07-03 默认打印串口设为_EC600X_USART
    1.默认打印串口设为usart1；
    2.心跳包检查窗口改为10分钟。
