phoenix9668/Collector/(notices)

Notices in the files:
Core/Inc/main.h:
© Copyright (c) 2022 STMicroelectronics.
All rights reserved.
This software component is licensed by ST under Ultimate Liberty license
Core/Src/usart.c:
Copyright (c) 2022 STMicroelectronics.
This software is licensed under terms that can be found in the LICENSE file
